DasunH/WolfTracker2014/Wolf Tracker/original_154245_jUmatnn3A8LtPPplB7qYOvOCr.jpg

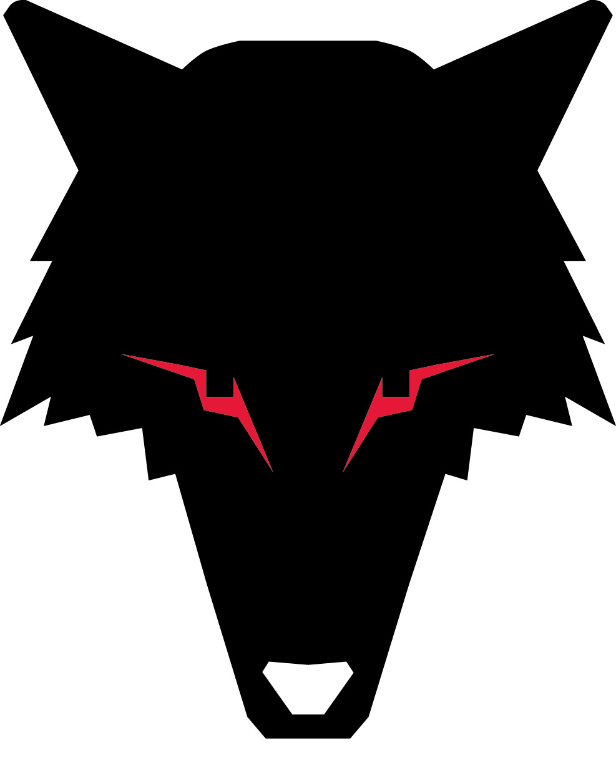
Wolf Tracker/original_154245_jUmatnn3A8LtPPplB7qYOvOCr.jpg
