DasunH/WolfTracker2014/Purchases/PurchasingTemplate.xlsx

PRODUCT | PART NUMBER | JUSTIFICATION | UNIT PRICE | QUANTITY | TOTAL PRICE | PURCHASING LINK
GoPro Hero3 White Edition |  | Capture Video | $199.99 | 1 | $199.99 | http://gopro.com/cameras/hd-hero3-white-edition
