DasunH/WolfTracker2014/Purchases/Wolf Tracker Parts List.xlsx

Part Name | Part Number | Unit Price | Quantity | Total Price | Link
32 Pitch Hub Gear (1" Bore) | 615222 | 12.99 | 1 | 12.99 | http://www.servocity.com/html/32_pitch_hub_gears__1__bore_.html#.U-pzZ4BdVy8
32 Pitch Aluminum Hub Gear (1/2" Bore) | 615210 | 12.99 | 1 | 12.99 | http://www.servocity.com/html/32_pitch_aluminum_hub_gears__1.html#.U-p0z4BdVy8
Flanged Ball Berings | 535049 | 2.79 | 1 | 2.79 | http://www.servocity.com/html/flanged_ball_bearings.html#.U-p1P4BdVy8
Swivel Hub | 545364 | 6.99 | 2 | 13.98 | http://www.servocity.com/html/swivel_hub__545364_.html#.U-p1xoBdVy8
Attachment Blocks | 585400 | 9.99 | 1 | 9.99 | http://www.servocity.com/html/attachment_blocks.html#.U-p2j4BdVy8
90 Degree Dual Side Mount B | 585508 | 5.99 | 2 | 11.98 | http://www.servocity.com/html/90o_dual_side_mount_b__585508_.html#.U-lxS4BdVy8
90 Degree Andle Bracket A | 858532 | 4.99 | 2 | 9.98 | http://www.servocity.com/html/90o_angle_bracket_a__585532_.html#.U-l0d4BdVy8
534-621 Bracket | 534-621 | 0.43 | 20 | 8.60 | http://www.servocity.com/html/534-621_bracket.html
1/2" Bore Tube Clamp Hub | 545350 | 5.99 | 2 | 11.98 | http://www.servocity.com/html/1_2__bore_tube_clamp_hub__5453.html#.U-p3ooBdVy8
90 Degree Hub Mount A | 545412 | 4.49 | 2 | 8.98 | http://www.servocity.com/html/90o_hub_mount_a__545412_.html#.U-p37oBdVy8
 |  |  | Total: | 104.26
