DasunH/WolfTracker2014/Purchases/Wolf-Turtle8-18.xlsx

Part Name | Part Number | Unit Price | Quantity | Total Price | Link
3/8" Aluminum Hex Standoff (1.5") | 91780A895 | $1.66 | 5 | $8.30 | http://www.mcmaster.com/#91780a895/=taixaf
3/8" Aluminum Hex Standoff (2.5") | 91780A901 | $1.94 | 5 | $9.70 | http://www.mcmaster.com/#91780a901/=taixp4
#25 Chain | 6261K171 | $30.84 | 1 | $30.84 | http://www.mcmaster.com/#6261k171/=taixpi
20 RPM Motor | 638174 | $24.99 | 1 | $24.99 | http://www.servocity.com/html/20_rpm_gear_motor.html
 |  |  | Total Cost: | $73.83
 | s
