DasunH/WolfTracker2014/Purchases/WolfPurchases7-22.xlsx

Product | Part Number | JUSTIFICATION | UNIT PRICE | QUANTITY | TOTAL PRICE | PURCHASING LINK
K478 Snow/Mud Tires | 160685 |  | $37.59 | 4 | $150.36 | http://www.jackssmallengines.com/Parts-Lookup/160685/61323/PL
Lead Acid Batteies | SLA-9A65 |  | $159.95 | 2 | $319.90 | http://www.batterymart.com/p-9a65-12-volt-group-65-agm-battery.html
D-Profile Shafts | 8632T7 (http://www.mcmaster.com/) |  | $9.93 | 4 | $39.72 | http://www.mcmaster.com/#8632t7/=syqar8
Flanged Ball Bearings | 535049 |  | $2.79 | 8 | $22.32 | http://www.servocity.com/html/flanged_ball_bearings.html#.U8_4avldWkB
Set Screw Hubs | 545560 |  | $4.99 | 12 | $59.88 | http://www.servocity.com/html/0_770__set_screw_hubs.html#.U8_6svldWkB
Hub Mount Sprokets | 615102 |  | $3.99 | 8 | $31.92 | http://www.servocity.com/html/aluminum_hub_mount_sprockets__.html#.U8_8V_ldWkB
Metal Chain | C250 |  | $8.99 | 10 | $89.90 | http://www.servocity.com/html/metal_chain.html#.U9AABPldWkB
Set Screw Collars | 6432K16 |  | $1.74 | 8 | $13.92 | http://www.servocity.com/html/steel_set_screw_collars.html#.U9ABd_ldWkA
Aluminum 90 Degree | 8982K61 |  | $15.53 | 1 | 15.53 | http://www.mcmaster.com/#8982k61/=t1uya7
Battery Terminal Connector | 7106K11 |  | 5.29 | 4 | $21.16 | http://www.mcmaster.com/#7106k11/=syb20a
Black 10 Gauge Wire |  |  | 2.5 | 7 | $17.50 | http://www.servocity.com/html/battery_wire.html#.U9ggefldWkA
Red 10 Gauge Wire |  |  | 2.5 | 2 | $5.00 | http://www.servocity.com/html/battery_wire.html#.U9ggefldWkA
 |  |  |  |  | $764.61
