DasunH/WolfTracker2014/Purchases/WolfPurchases8-11.xlsx

PRODUCT | PART NUMBER | JUSTIFICATION | UNIT PRICE | QUANTITY | TOTAL PRICE | PURCHASING LINK
Stainless Steel Friction Hinge | 1460A1 |  | $21.00 | 2 | $42.00 | http://www.mcmaster.com/#1460a1/=t8nnhd
90° Hub Mount Bracket A | 585494 |  | $5.99 | 8 | $47.92 | http://www.servocity.com/html/90o_hub_mount_bracket_a__58549.html#.U-lrO_ldWkA
90° Dual Side Mount | 585470 |  | $5.99 | 1 | $5.99 | http://www.servocity.com/html/90o_dual_side_mount__585470_.html#.U-lrJ_ldWkB
4-40 1" Standoffs | 91780A755 |  | $0.37 | 35 | $12.95 | http://www.mcmaster.com/#91780a755/=t9238x
 |  |  |  | Total | $108.86
