DasunH/WolfTracker2014/Purchases/WolfPurchases8-5.xlsx

PRODUCT | PART NUMBER | JUSTIFICATION | UNIT PRICE | QUANTITY | TOTAL PRICE | PURCHASING LINK
Wheel & Tire Assembly | V58-6510 |  | $29.99 | 4 | $119.96 | http://www.monsterscooterparts.com/13-5-6-minimoto-jeep-dune-buggy-front-wheel-assembly.html
Pelican 1095 Case | 1090-020-110 |  | $66.99 | 1 | $66.99 | http://www.amazon.com/Pelican-Products-1095-HardBack-1090-020-110/dp/B0069IYAA8
Battery Terminal Connector | 7106K11 |  | $5.29 | 4 | $21.16 | http://www.mcmaster.com/#7106k11/=syb20a
Black 10 Gauge Wire | W10 Black |  | $2.50 | 7 | $17.50 | http://www.servocity.com/html/battery_wire.html#.U9ggefldWkA
Red 10 Gauge Wire | W10 Red |  | $2.50 | 2 | $5.00 | http://www.servocity.com/html/battery_wire.html#.U9ggefldWkA
 |  |  |  | Total: | $230.61
