DasunH/WolfTracker2014/Wolf/Wolf Tracker 4.0/Final V4/Prototype ATR Wheel Assembly V3.SLDASM

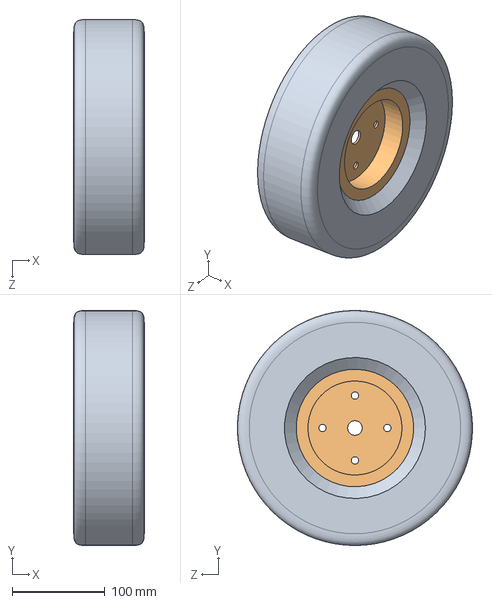
[picture p25: CAD file, 2014-09-02]
Wolf/Wolf Tracker 4.0/Final V4/Prototype ATR Wheel Assembly V3.SLDASM
76.2 x 254.0 x 253.9 mm
Prototype ATR Tire V3
Prototype ATR Wheel Rim V3
