DasunH/WolfTracker2014/Wolf Tracker/Final V4/Final Rover Assembly V4.SLDASM

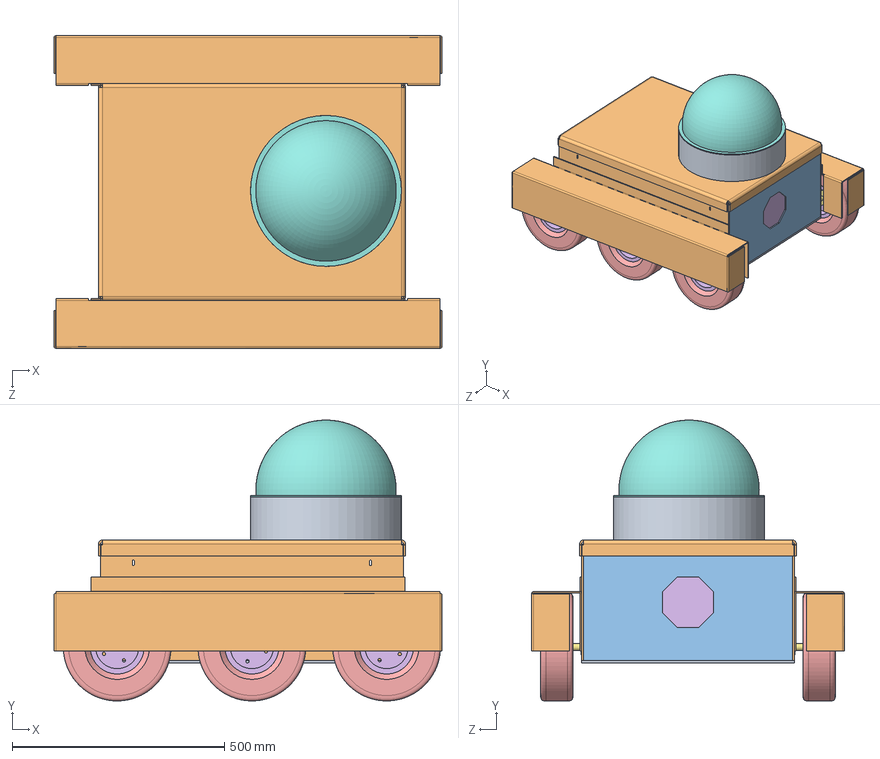
[picture p26: CAD file, 2014-09-02]
Wolf Tracker/Final V4/Final Rover Assembly V4.SLDASM
914.4 x 662.0 x 737.2 mm
Final Base-Bottom V4
Final Base-LR V4 x 2
Final Base-FB V4 x 2
Prototype IG52 Motor x 6
Prototype ATR Tire V3 x 6
Prototype ATR Wheel Rim V3 x 6
Prototype ATR Wheel Hub V3 x 6
Final Aluminum Bar V4 x 2
Final 0.625'' Bore Sealed Bearing V4 x 6
Final Case Top V4
Prototype No 5 Corner Piece V3 x 4
Atom Board
Final 24-12V Converter
Final 120MM Fan x 2
Final Inside Corner Bracket x 8
EZtop Dome
PVC Pipe
Final Tire Cover V4 x 2
