DasunH/WolfTracker2014/Wolf Tracker/Final V4/Final ATR Drivetrain Assembly V4.SLDASM

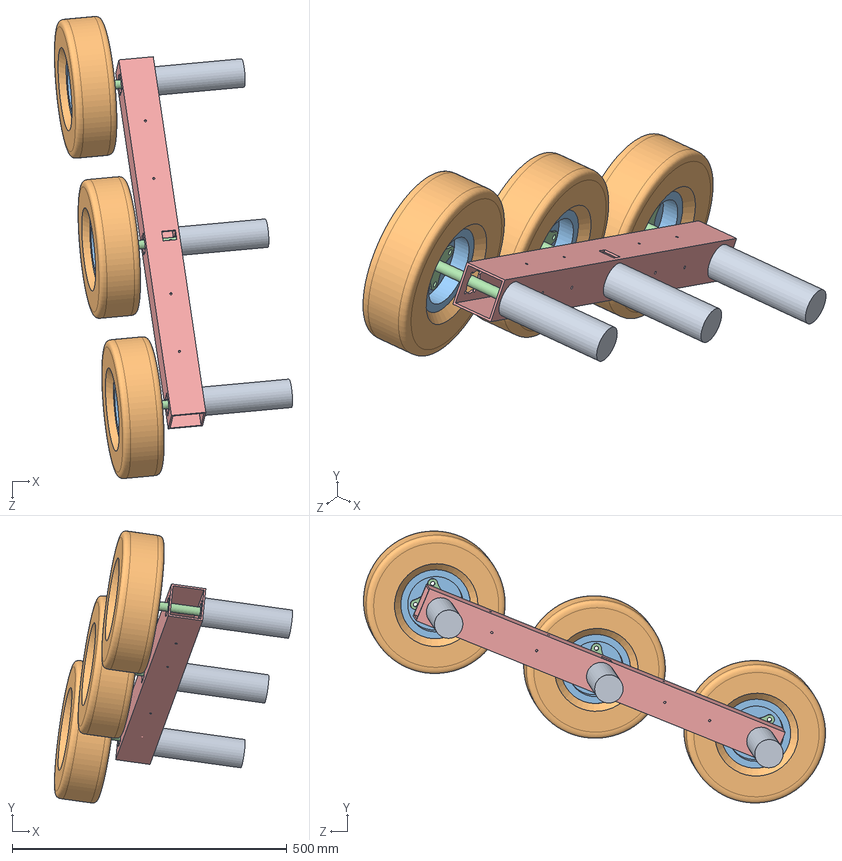
[picture p27: CAD file, 2014-09-02]
Wolf Tracker/Final V4/Final ATR Drivetrain Assembly V4.SLDASM
433.6 x 495.0 x 841.2 mm
Prototype IG52 Motor x 3
Prototype ATR Tire V3 x 3
Prototype ATR Wheel Rim V3 x 3
Prototype ATR Wheel Hub V3 x 3
Final Aluminum Bar V4
