DasunH/WolfTracker2014/Wolf/WolfTurret2.0/Turrent3.0.SLDASM

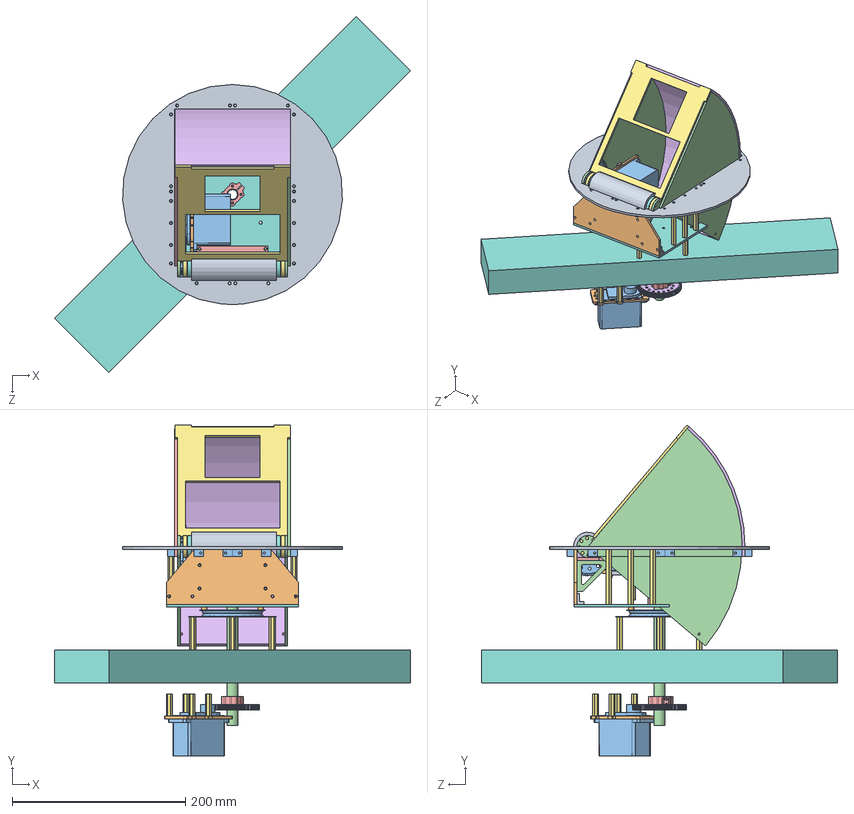
[picture p28: CAD file, 2014-09-02]
Wolf/WolfTurret2.0/Turrent3.0.SLDASM
410.9 x 382.0 x 410.9 mm
TurretBasePlate
BottomMountingPlate
SquareMountingBracket x 16
TurretSideProtectionRight
TurretSideProtectionLeft
TurretShieldBacking
HexStandoffInch x 10
TurningPlate
LongSquareBracket x 3
Spacer x 4
Turntable
TriangleMountingBracket x 2
BottomMountingPlateTop3
CircleMountingBracket x 2
Swivel HubScrew x 2
Swivel HubNut x 2
NylonNut x 2
HexScrew(.3125) x 2
HalfBore84TCUT
TurretSidePannel x 2
AllignmentDowel x 2
TurretBackPlate
TurretFrontPannel2.0
2by4
PVCShield
ServoMount2 x 2
QuarterServo x 2
.5InchTube
.5InchTubeClamp x 2
.5InchBore76ToothGear
OneInchStandoff x 5
