DasunH/WolfTracker2014/WolfTurret2.0/TiltServoMount2.SLDASM

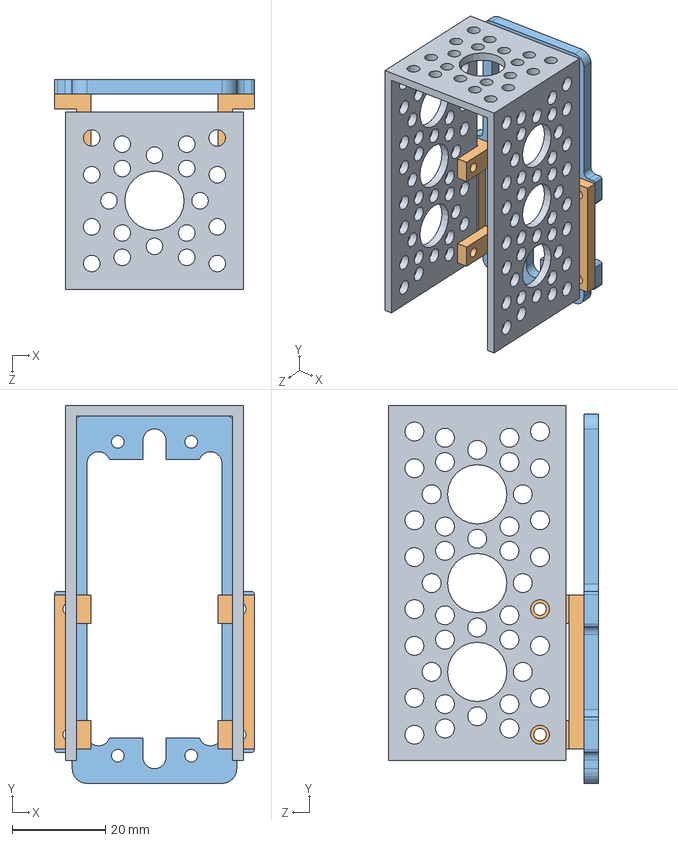
[picture p29: CAD file, 2014-09-02]
WolfTurret2.0/TiltServoMount2.SLDASM
42.9 x 81.1 x 45.1 mm
ChannelABracket
LongSquareBracket x 2
ServoMount
