DasunH/WolfTracker2014/Wolf Tracker 2.0/NewTire.SLDPRT

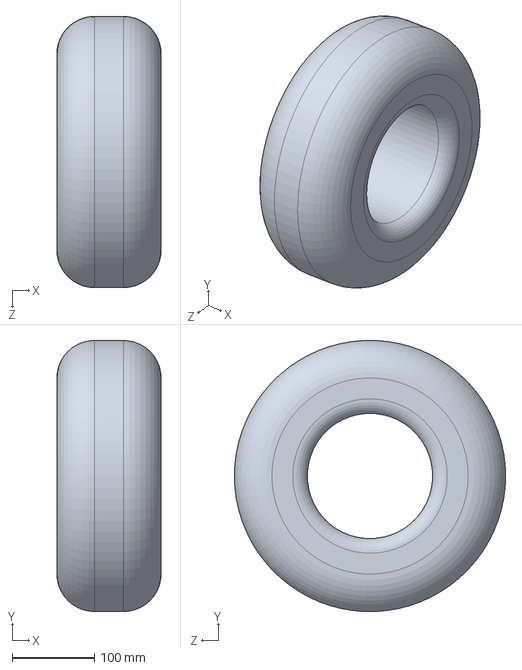
[picture p30: CAD file, 2014-09-02]
Wolf Tracker 2.0/NewTire.SLDPRT
127.0 x 329.9 x 330.2 mm
