DasunH/WolfTracker2014/Wolf Tracker 3.0/BasePlate.SLDPRT

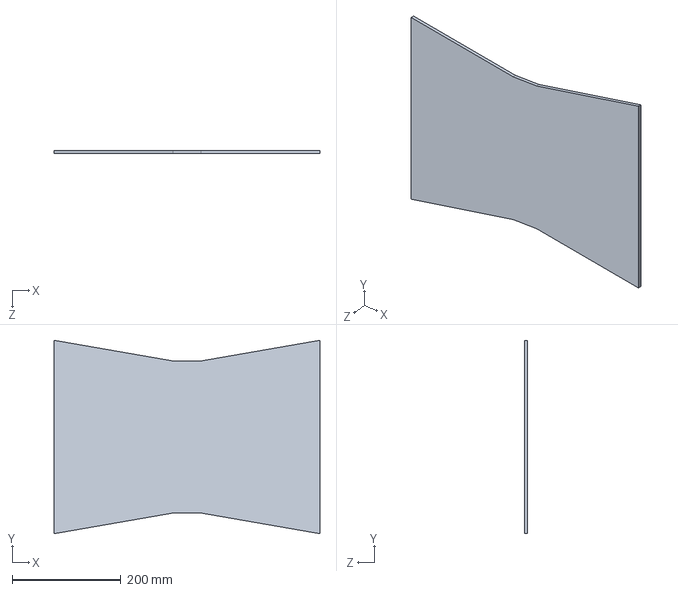
[picture p31: CAD file, 2014-09-02]
Wolf Tracker 3.0/BasePlate.SLDPRT
489.0 x 355.6 x 6.35 mm
