DasunH/WolfTracker2014/Wolf Tracker 4.0/Final V4/Final 0.625'' Bore Sealed Bearing V4.SLDPRT

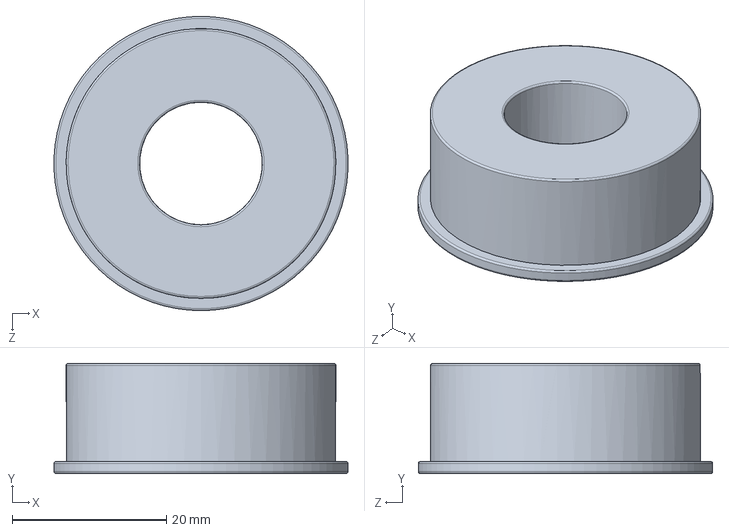
[picture p32: CAD file, 2014-09-02]
Wolf Tracker 4.0/Final V4/Final 0.625'' Bore Sealed Bearing V4.SLDPRT
38.1 x 14.3 x 38.1 mm
