DasunH/WolfTracker2014/Wolf Tracker 4.0/Final V4/Mill/Final Aluminum Bar V4.SLDPRT

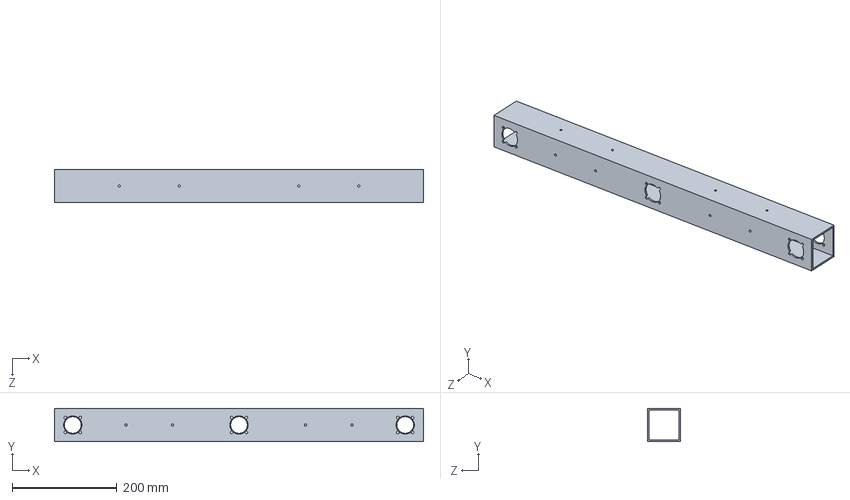
[picture p33: CAD file, 2014-09-02]
Wolf Tracker 4.0/Final V4/Mill/Final Aluminum Bar V4.SLDPRT
704.9 x 63.5 x 63.5 mm
