DasunH/WolfTracker2014/Wolf Tracker/Final V4/Final Base-FB V4.SLDPRT

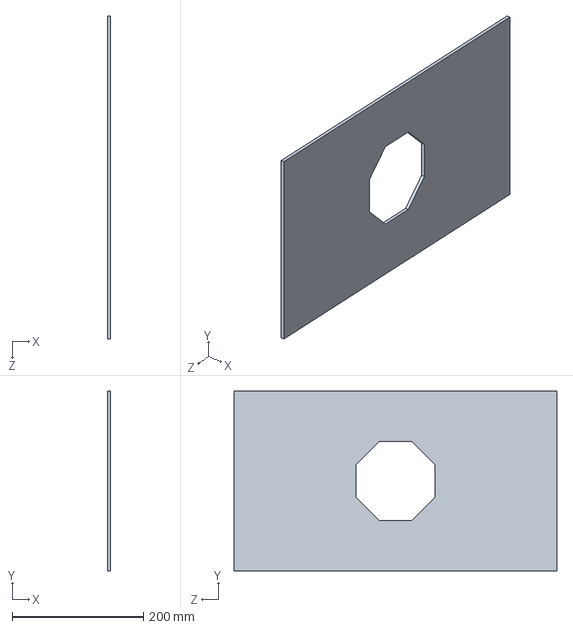
[picture p34: CAD file, 2014-09-02]
Wolf Tracker/Final V4/Final Base-FB V4.SLDPRT
4.76 x 274.6 x 492.1 mm
