DasunH/WolfTracker2014/Wolf/Wolf Tracker 4.0/Final V4/Final Case Top V4.SLDPRT

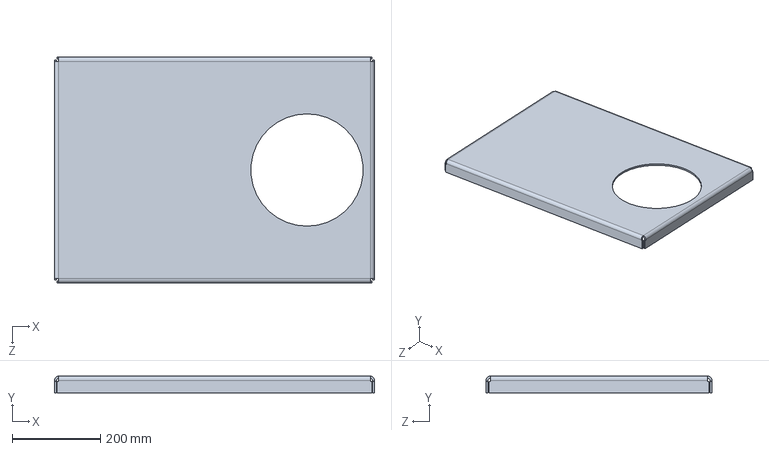
[picture p35: CAD file, 2014-09-02]
Wolf/Wolf Tracker 4.0/Final V4/Final Case Top V4.SLDPRT
723.9 x 38.1 x 511.0 mm
