DasunH/WolfTracker2014/Wolf/Wolf Tracker 4.0/New Back Plate.SLDPRT

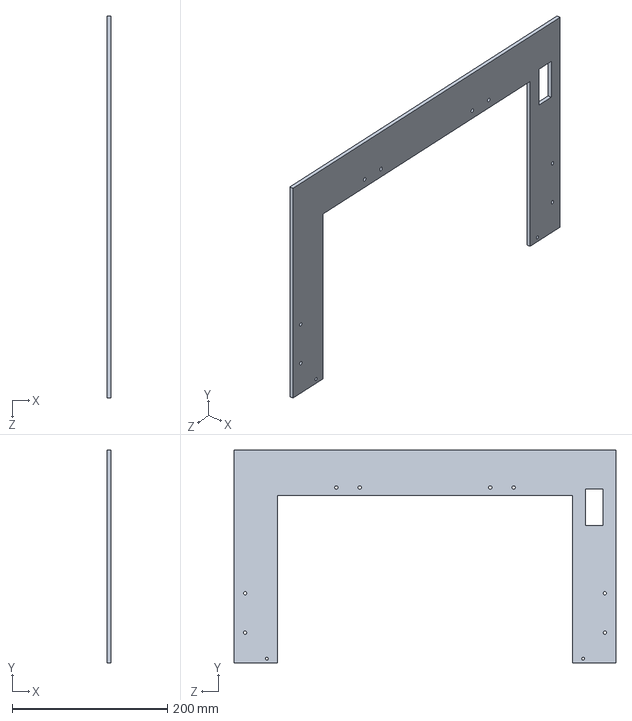
[picture p36: CAD file, 2014-09-02]
Wolf/Wolf Tracker 4.0/New Back Plate.SLDPRT
4.76 x 274.6 x 492.1 mm
