DasunH/WolfTracker2014/Wolf/WolfTurret2.0/TurretFrontPannel2.0.SLDPRT

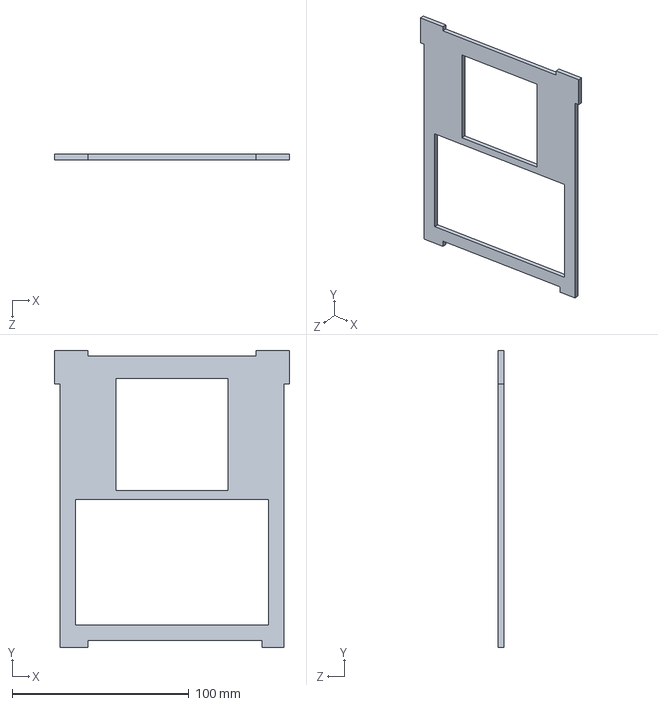
[picture p37: CAD file, 2014-09-02]
Wolf/WolfTurret2.0/TurretFrontPannel2.0.SLDPRT
133.4 x 168.3 x 3.17 mm
