DasunH/WolfTracker2014/WolfTurret2.0/BottomMountingPlateTop3.SLDPRT

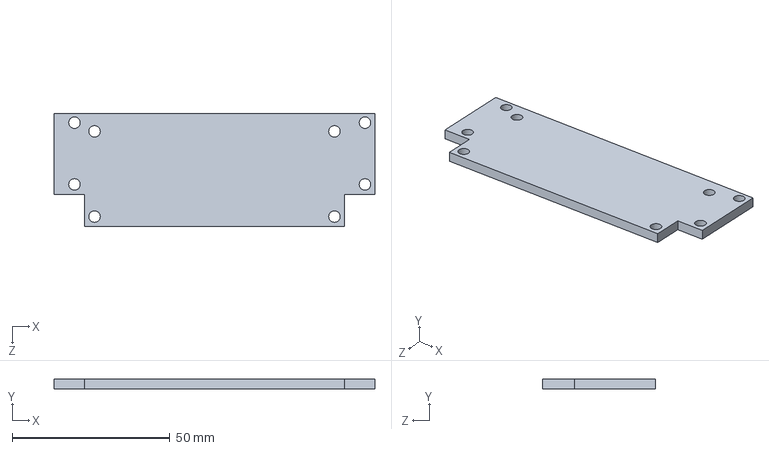
[picture p38: CAD file, 2014-09-02]
WolfTurret2.0/BottomMountingPlateTop3.SLDPRT
101.6 x 3.17 x 35.8 mm
