DasunH/WolfTracker2014/Wolf Tracker 2.0/MotorBracket.SLDPRT

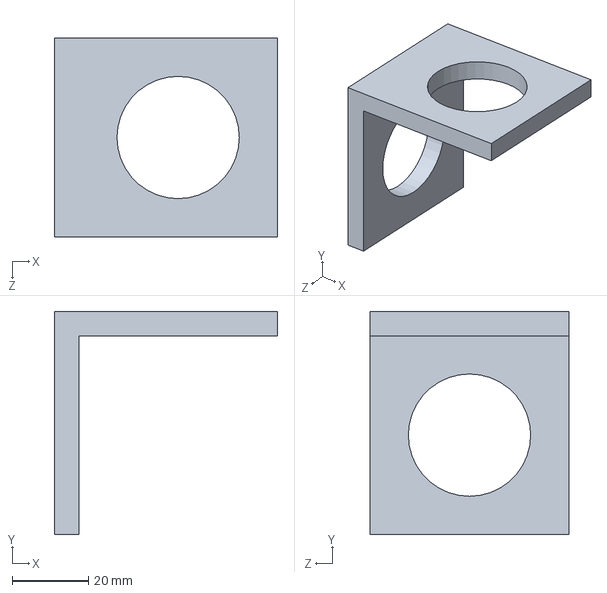
[picture p39: CAD file, 2014-09-02]
Wolf Tracker 2.0/MotorBracket.SLDPRT
58.4 x 58.4 x 52.0 mm
