DasunH/WolfTracker2014/Wolf Tracker 4.0/BatteryRail1.SLDPRT

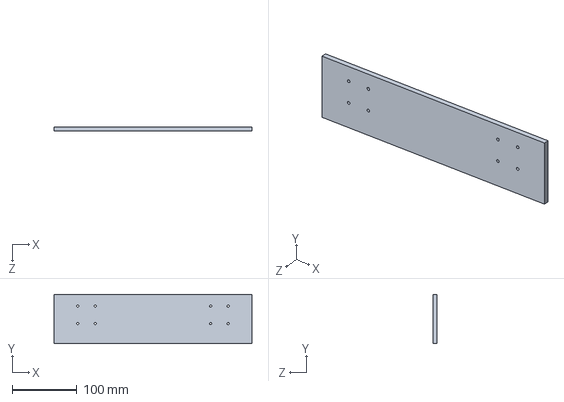
[picture p40: CAD file, 2014-09-02]
Wolf Tracker 4.0/BatteryRail1.SLDPRT
304.8 x 76.2 x 6.35 mm
