DasunH/WolfTracker2014/Wolf Tracker 4.0/Final V4/Final Aluminum Bar V4II.SLDPRT

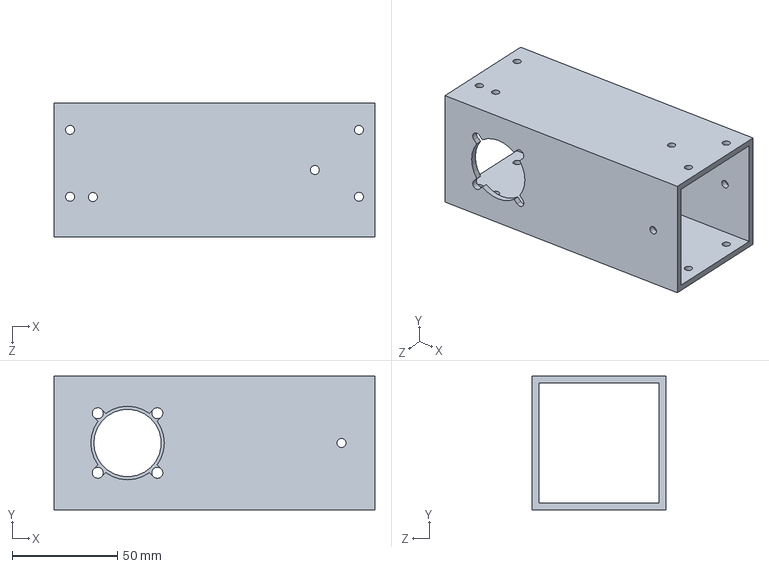
[picture p41: CAD file, 2014-09-02]
Wolf Tracker 4.0/Final V4/Final Aluminum Bar V4II.SLDPRT
152.4 x 63.5 x 63.5 mm
