DasunH/WolfTracker2014/Wolf/WolfTurret2.0/TurretSidePannel.SLDPRT

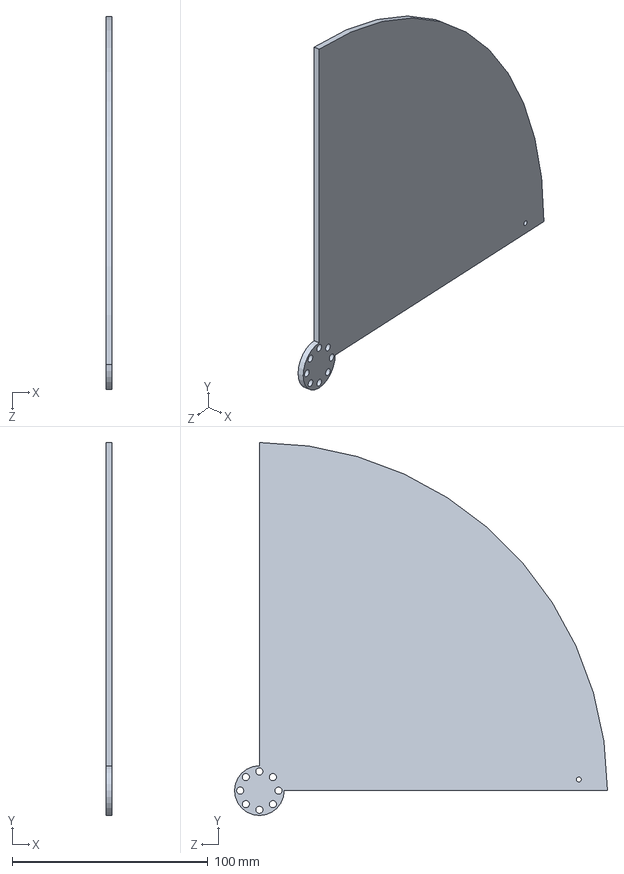
[picture p42: CAD file, 2014-09-02]
Wolf/WolfTurret2.0/TurretSidePannel.SLDPRT
3.17 x 190.5 x 190.5 mm
