DasunH/WolfTracker2014/WolfTurret2.0/HexStandoffInch.SLDPRT

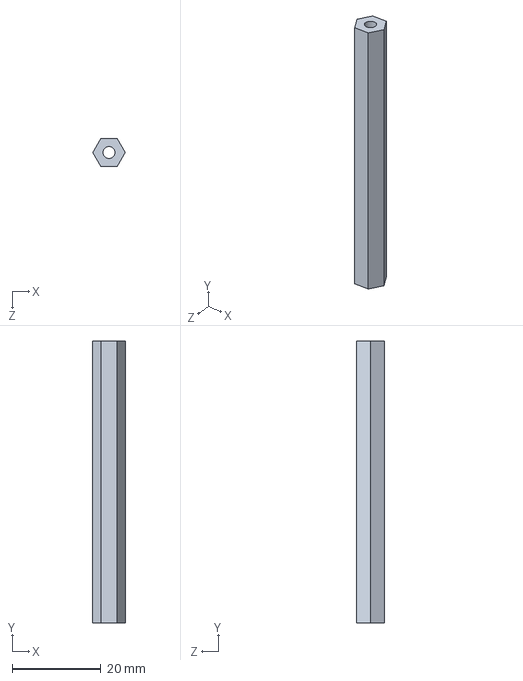
[picture p43: CAD file, 2014-09-02]
WolfTurret2.0/HexStandoffInch.SLDPRT
7.33 x 63.5 x 6.37 mm
