DasunH/WolfTracker2014/Wolf Tracker 2.0/Motor.SLDPRT

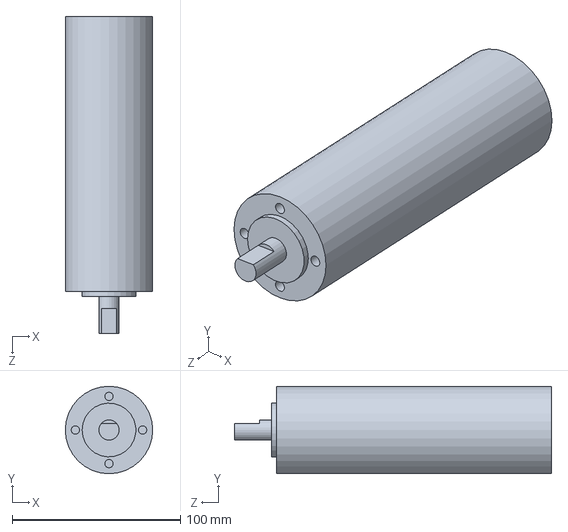
[picture p44: CAD file, 2014-09-02]
Wolf Tracker 2.0/Motor.SLDPRT
52.0 x 52.0 x 188.5 mm
