DasunH/WolfTracker2014/Wolf Tracker 3.0/SuspensionPlates.SLDPRT

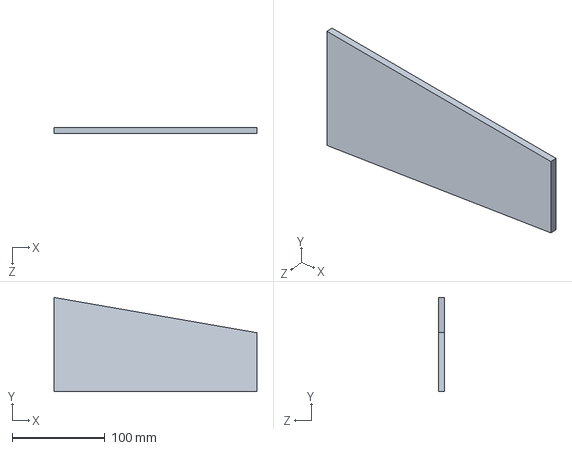
[picture p45: CAD file, 2014-09-02]
Wolf Tracker 3.0/SuspensionPlates.SLDPRT
219.1 x 101.6 x 6.35 mm
