DasunH/WolfTracker2014/Wolf Tracker 4.0/Final V4/Final Tire Cover V4.SLDPRT

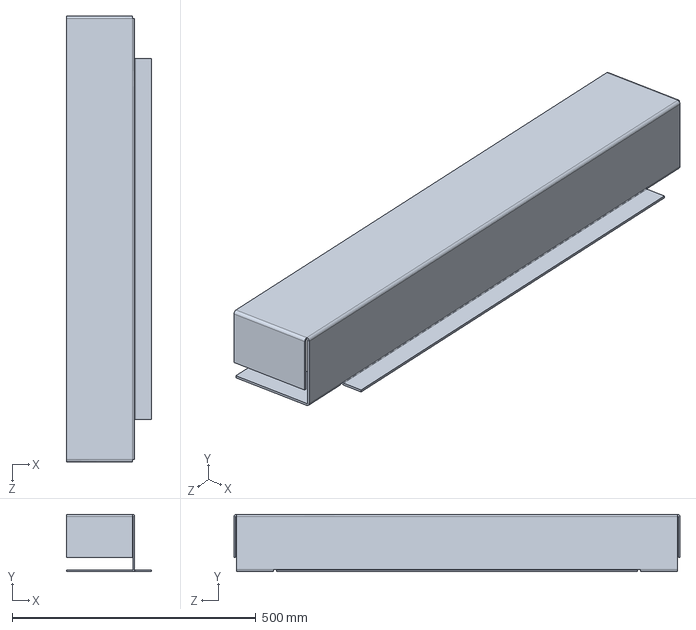
[picture p46: CAD file, 2014-09-02]
Wolf Tracker 4.0/Final V4/Final Tire Cover V4.SLDPRT
174.6 x 117.8 x 914.4 mm
