DasunH/WolfTracker2014/Wolf Tracker 4.0/New Back Plate.SLDPRT

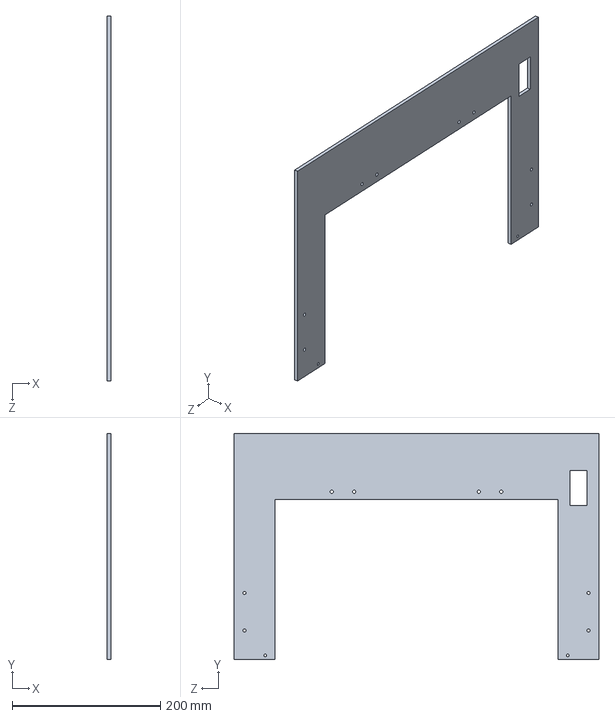
[picture p47: CAD file, 2014-09-02]
Wolf Tracker 4.0/New Back Plate.SLDPRT
4.76 x 304.8 x 492.1 mm
