DasunH/WolfTracker2014/Wolf Tracker/Final V4/Prototype ATR Wheel Rim V3.SLDPRT

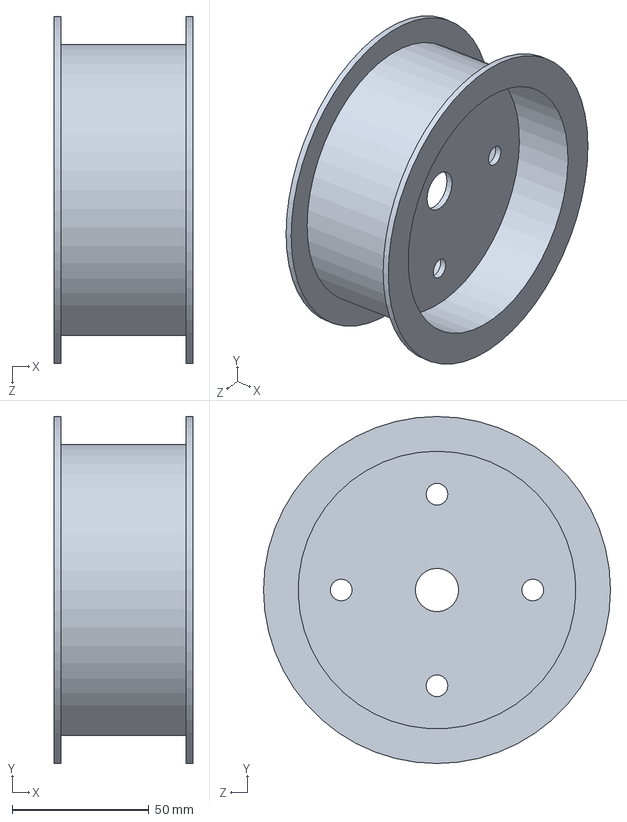
[picture p48: CAD file, 2014-09-02]
Wolf Tracker/Final V4/Prototype ATR Wheel Rim V3.SLDPRT
50.8 x 127.0 x 127.0 mm
