DasunH/WolfTracker2014/Wolf/Wolf Tracker 4.0/8-32--buttonhead.SLDPRT

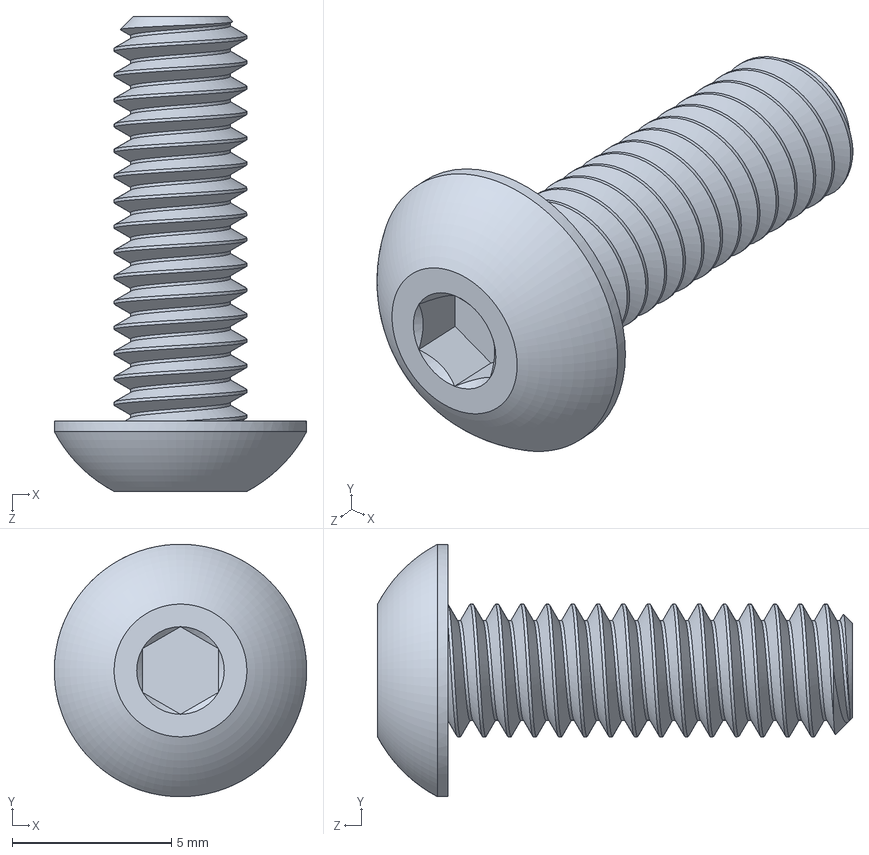
[picture p49: CAD file, 2014-09-02]
Wolf/Wolf Tracker 4.0/8-32--buttonhead.SLDPRT
7.92 x 7.92 x 14.9 mm
