DasunH/WolfTracker2014/Wolf/Wolf Tracker 4.0/Final V4/Final Gimbal Protector.SLDPRT

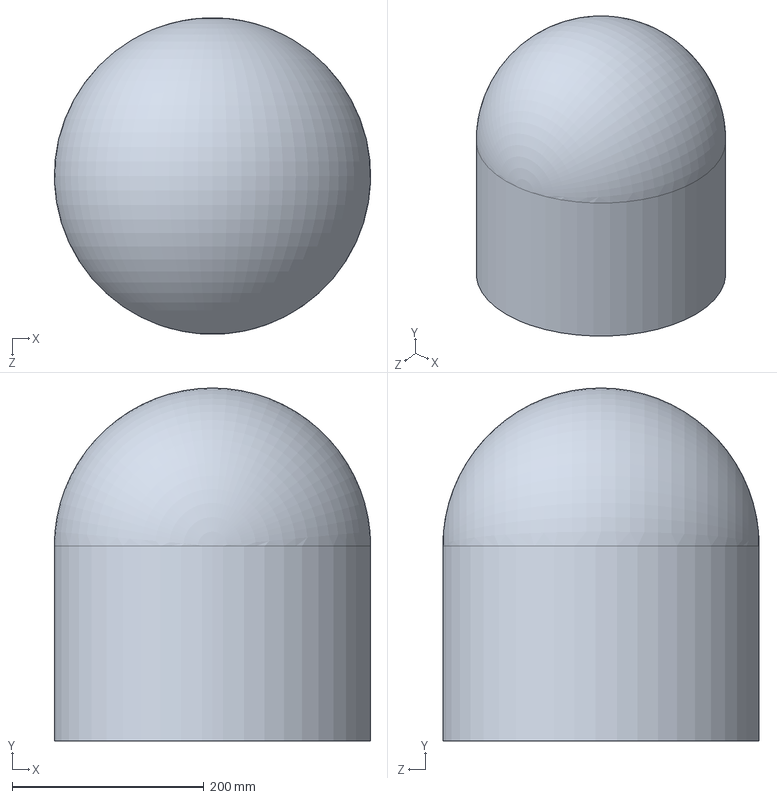
[picture p50: CAD file, 2014-09-02]
Wolf/Wolf Tracker 4.0/Final V4/Final Gimbal Protector.SLDPRT
330.0 x 368.3 x 330.2 mm
