DasunH/WolfTracker2014/WolfTurret2.0/.5InchTube.SLDPRT

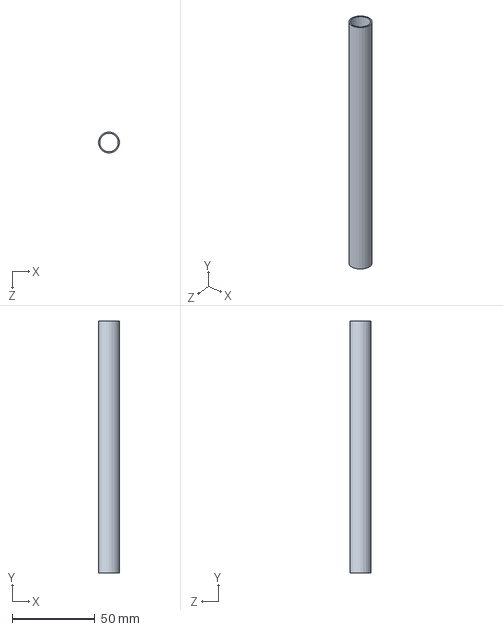
[picture p51: CAD file, 2014-09-02]
WolfTurret2.0/.5InchTube.SLDPRT
12.7 x 152.4 x 12.7 mm
