DasunH/WolfTracker2014/Wolf Tracker 3.0/Spine.SLDPRT

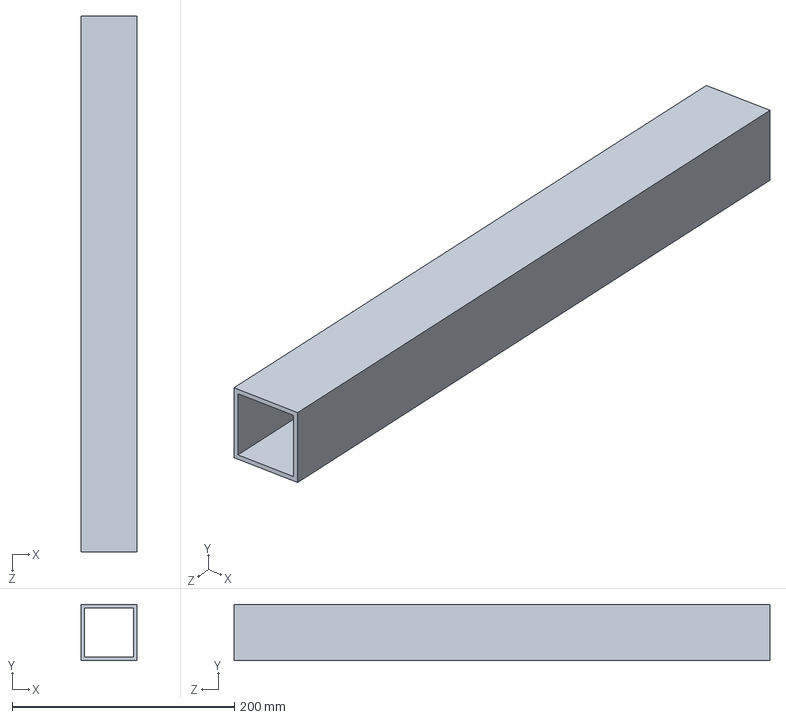
[picture p52: CAD file, 2014-09-02]
Wolf Tracker 3.0/Spine.SLDPRT
50.8 x 50.8 x 482.6 mm
