DasunH/WolfTracker2014/Wolf Tracker/Final V4/Final 120MM Fan.SLDPRT

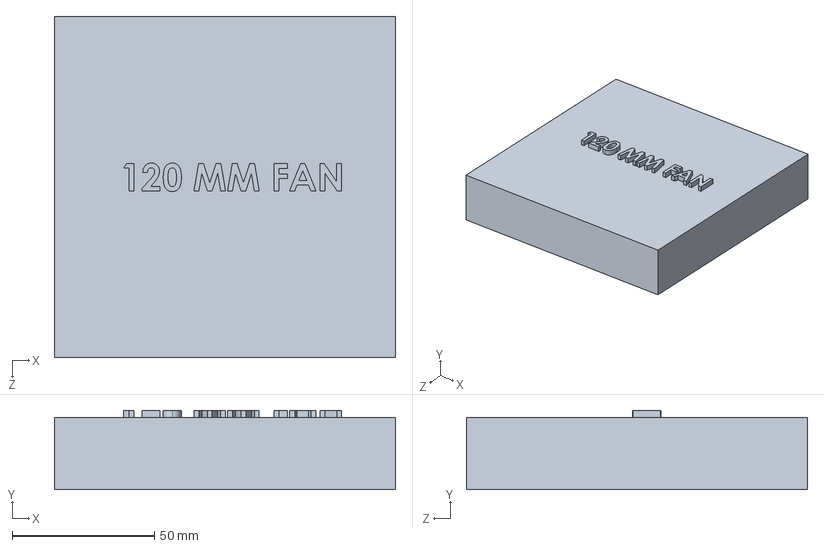
[picture p53: CAD file, 2014-09-02]
Wolf Tracker/Final V4/Final 120MM Fan.SLDPRT
120.0 x 27.9 x 120.0 mm
