DasunH/WolfTracker2014/Wolf/Wolf Tracker 4.0/Final V4/Prototype No 5 Corner Piece V3.SLDPRT

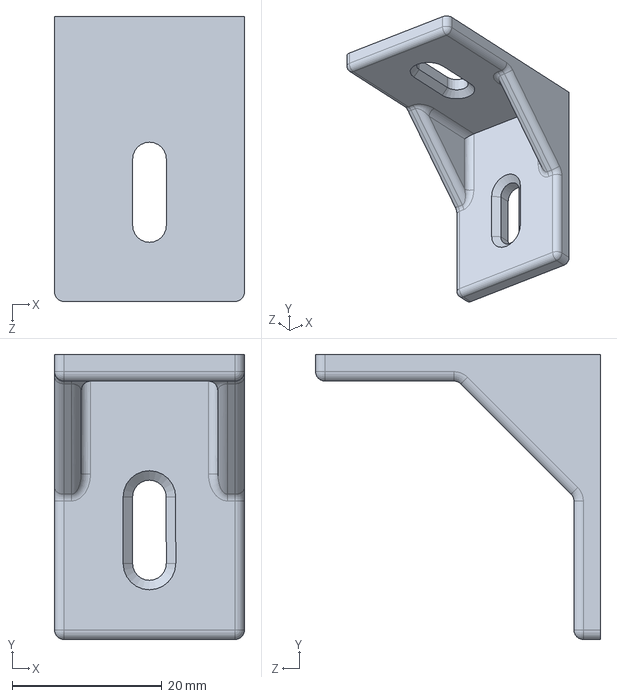
[picture p54: CAD file, 2014-09-02]
Wolf/Wolf Tracker 4.0/Final V4/Prototype No 5 Corner Piece V3.SLDPRT
25.4 x 38.1 x 38.1 mm
