DasunH/WolfTracker2014/Wolf/WolfTurret2.0/CameraMountingDimensions.SLDPRT

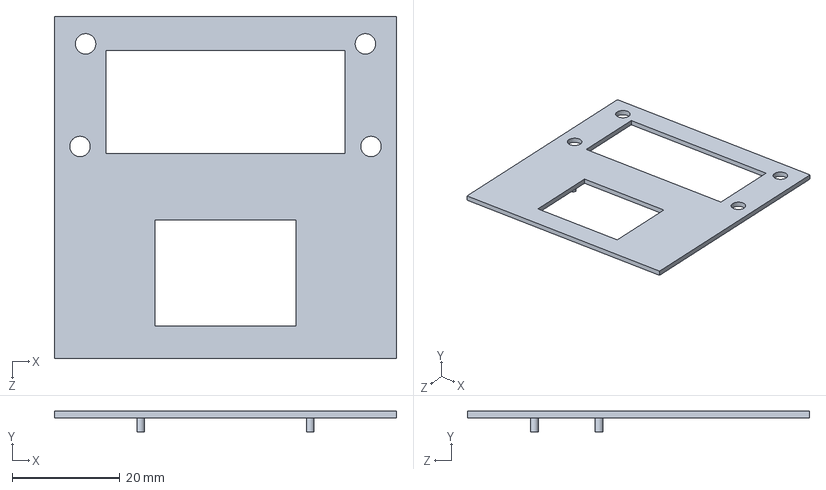
[picture p55: CAD file, 2014-09-02]
Wolf/WolfTurret2.0/CameraMountingDimensions.SLDPRT
63.5 x 3.81 x 63.5 mm
