DasunH/WolfTracker2014/WolfTurret2.0/NylonNut.SLDPRT

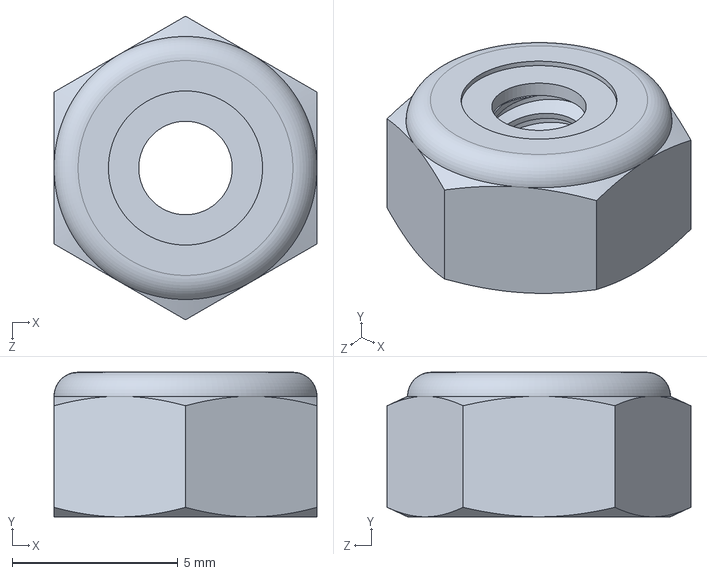
[picture p56: CAD file, 2014-09-02]
WolfTurret2.0/NylonNut.SLDPRT
7.94 x 4.37 x 9.17 mm
