DasunH/WolfTracker2014/Wolf Tracker 2.0/Battery.SLDPRT

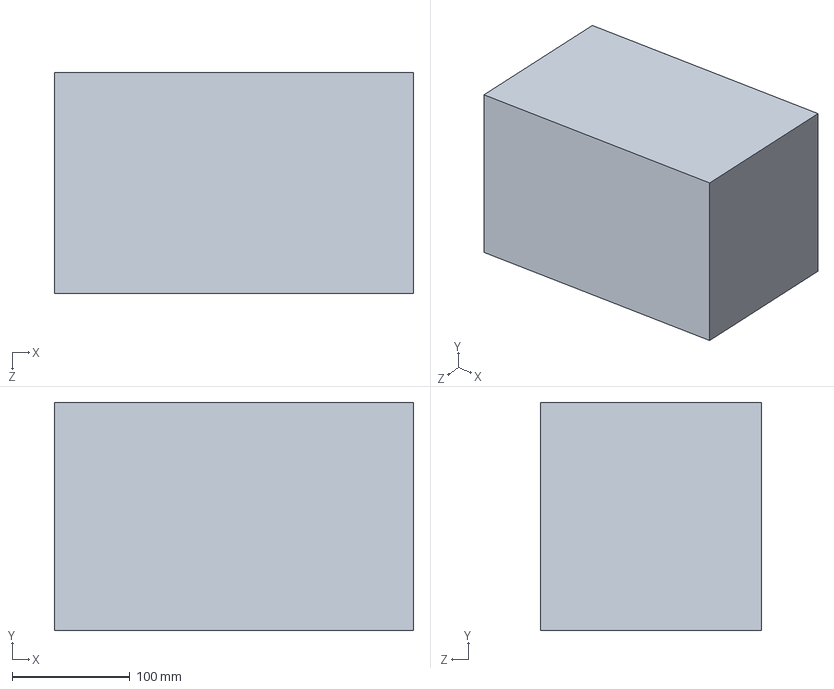
[picture p57: CAD file, 2014-09-02]
Wolf Tracker 2.0/Battery.SLDPRT
304.8 x 193.7 x 187.3 mm
