DasunH/WolfTracker2014/Wolf Tracker 4.0/Final V4/Final Tire Cover 4C.SLDPRT

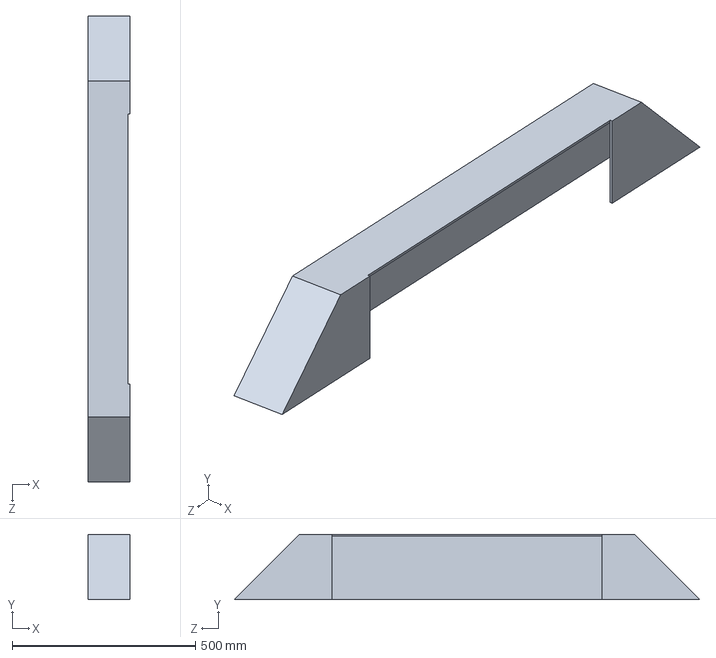
[picture p58: CAD file, 2014-09-02]
Wolf Tracker 4.0/Final V4/Final Tire Cover 4C.SLDPRT
114.3 x 177.8 x 1270.0 mm
