DasunH/WolfTracker2014/Wolf Tracker 4.0/Switch.SLDPRT

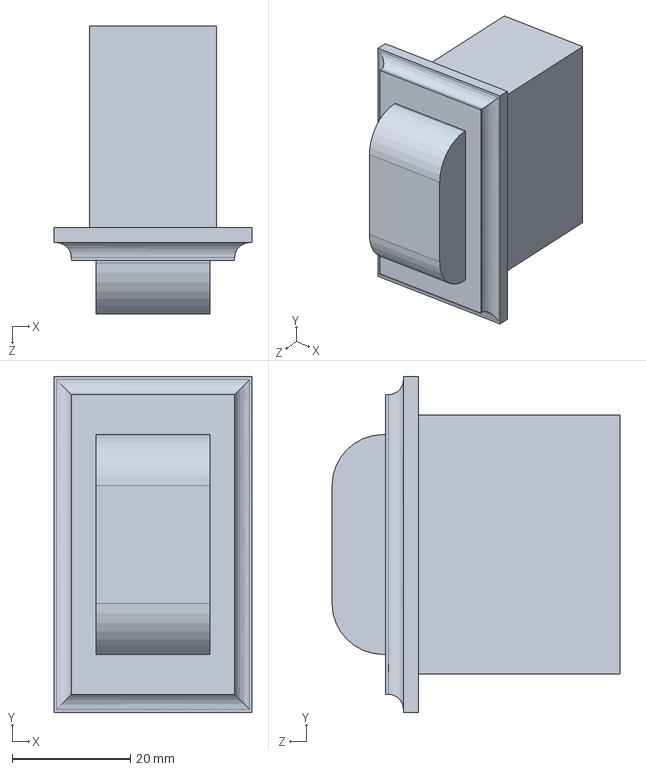
[picture p59: CAD file, 2014-09-02]
Wolf Tracker 4.0/Switch.SLDPRT
33.4 x 56.8 x 48.7 mm
