DasunH/WolfTracker2014/Wolf Tracker/Final V4/Final Tire Cover V4C.SLDPRT

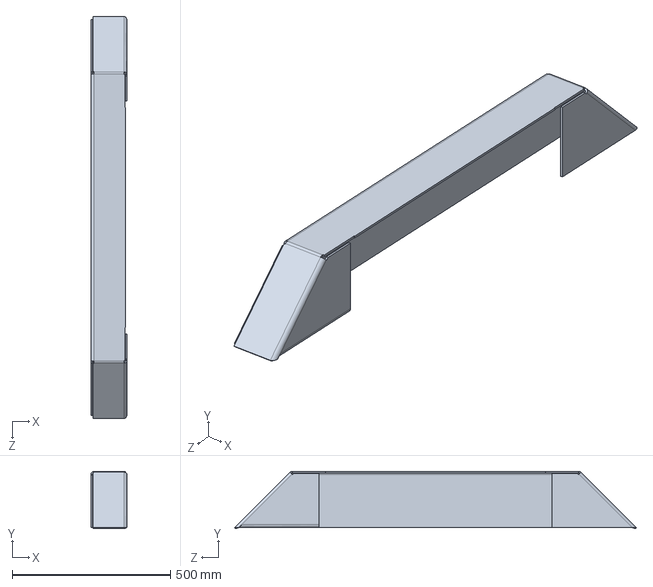
[picture p60: CAD file, 2014-09-02]
Wolf Tracker/Final V4/Final Tire Cover V4C.SLDPRT
114.3 x 181.2 x 1270.0 mm
