DasunH/WolfTracker2014/Wolf/Wolf Tracker 4.0/Final V4/Final Battery Base.SLDPRT

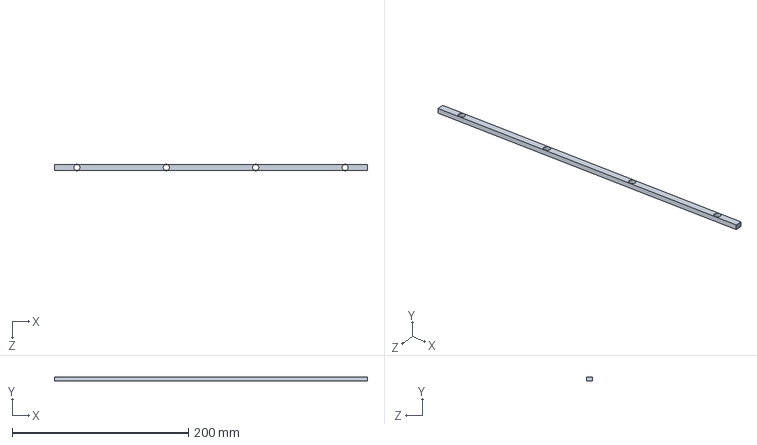
[picture p61: CAD file, 2014-09-02]
Wolf/Wolf Tracker 4.0/Final V4/Final Battery Base.SLDPRT
355.6 x 5.08 x 7.30 mm
