DasunH/WolfTracker2014/WolfTurret2.0/HalfBore48T.SLDPRT

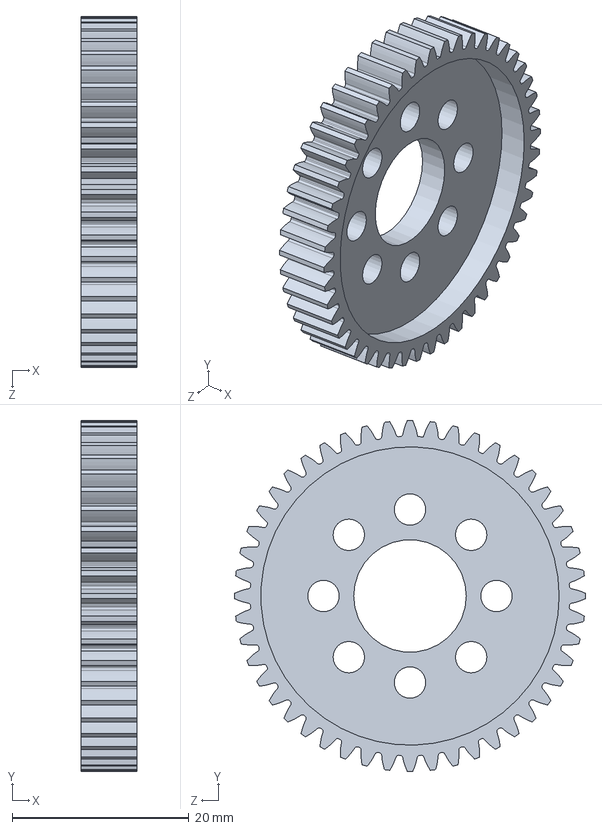
[picture p62: CAD file, 2014-09-02]
WolfTurret2.0/HalfBore48T.SLDPRT
6.35 x 39.7 x 39.7 mm
