DasunH/WolfTracker2014/Wolf Tracker 2.0/SidePanelLarge.SLDPRT

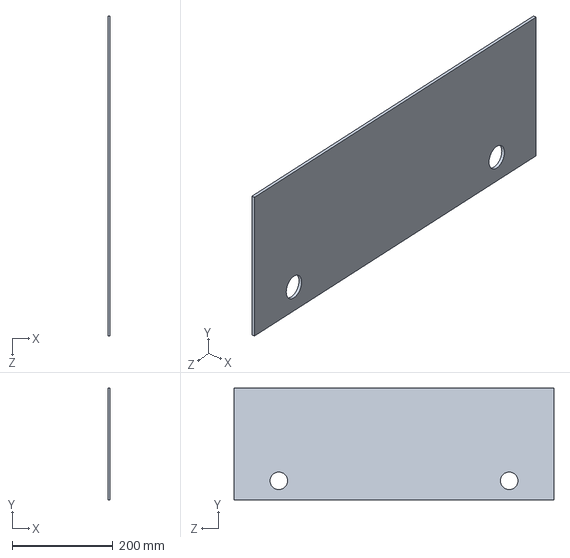
[picture p63: CAD file, 2014-09-02]
Wolf Tracker 2.0/SidePanelLarge.SLDPRT
4.76 x 222.2 x 635.0 mm
