DasunH/WolfTracker2014/Wolf Tracker 4.0/PelicanBracket.SLDPRT

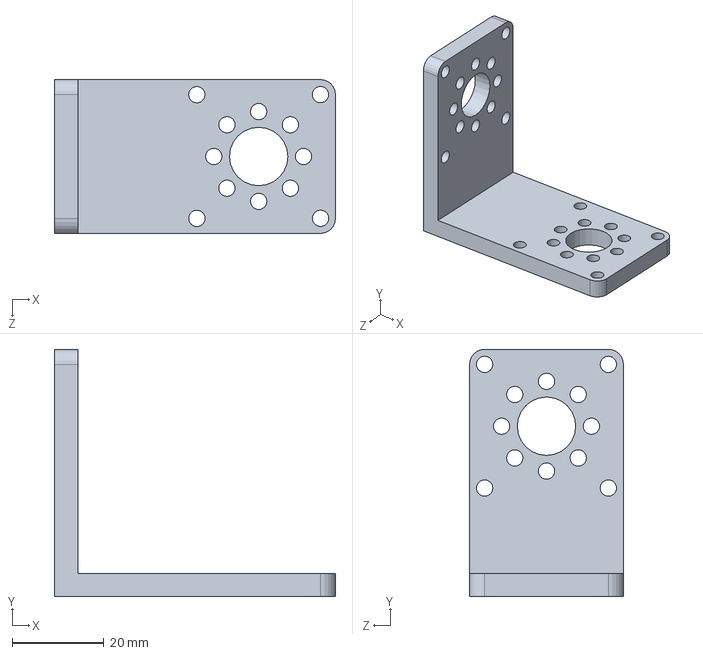
[picture p64: CAD file, 2014-09-02]
Wolf Tracker 4.0/PelicanBracket.SLDPRT
61.2 x 53.9 x 33.5 mm
