DasunH/WolfTracker2014/Wolf/Wolf Tracker 4.0/UnderrideGuard.SLDPRT

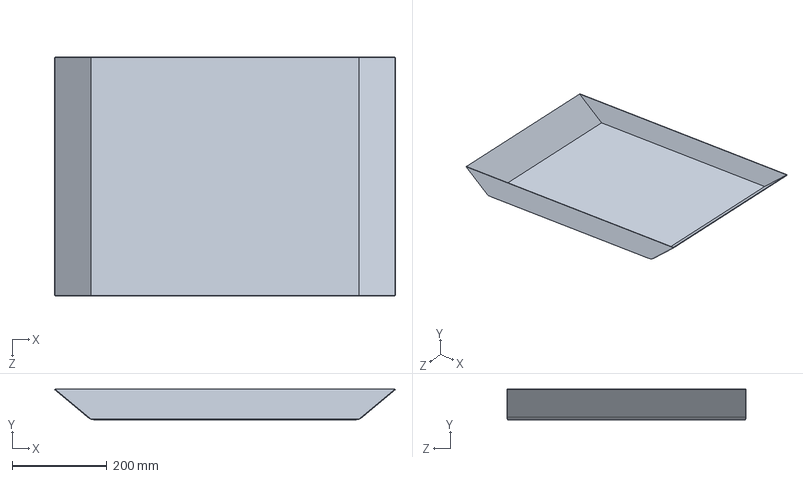
[picture p65: CAD file, 2014-09-02]
Wolf/Wolf Tracker 4.0/UnderrideGuard.SLDPRT
718.9 x 65.2 x 504.8 mm
