DasunH/WolfTracker2014/WolfTurret2.0/.5InchTubeClamp.SLDPRT

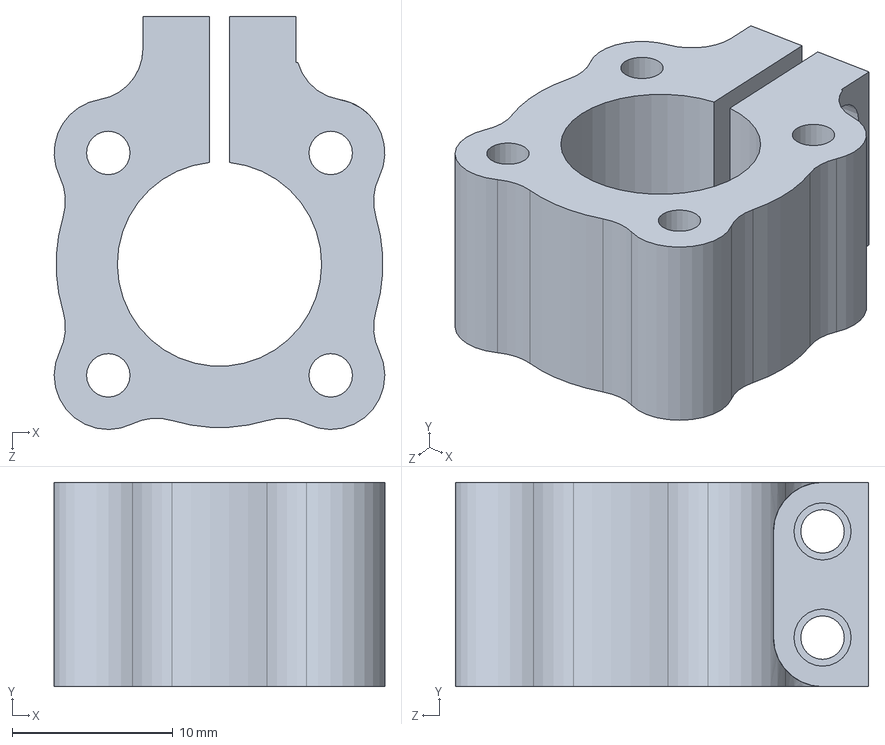
[picture p66: CAD file, 2014-09-02]
WolfTurret2.0/.5InchTubeClamp.SLDPRT
20.6 x 12.7 x 25.7 mm
