DasunH/WolfTracker2014/Wolf Tracker 2.0/Dome.SLDPRT

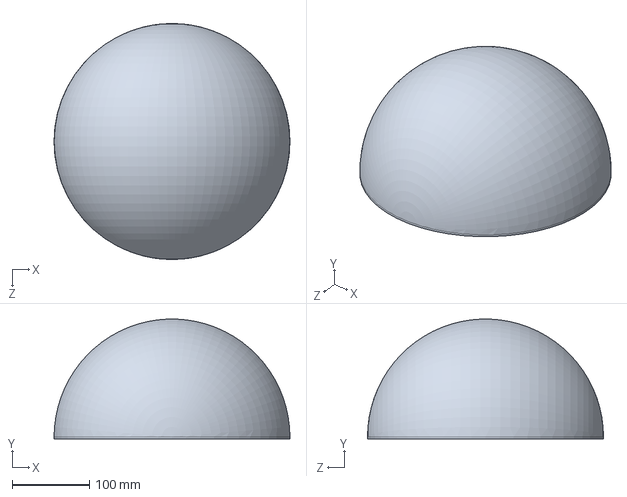
[picture p67: CAD file, 2014-09-02]
Wolf Tracker 2.0/Dome.SLDPRT
304.8 x 154.7 x 304.8 mm
