DasunH/WolfTracker2014/Wolf Tracker 4.0/Final V4/Prototype Polycarbonate Shelf V3B.SLDPRT

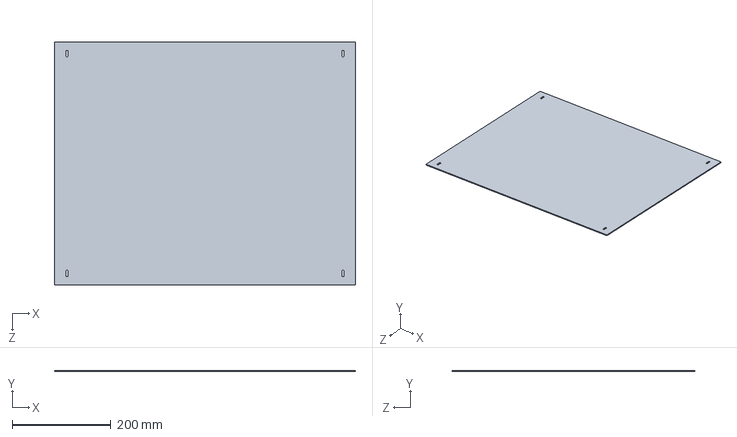
[picture p68: CAD file, 2014-09-02]
Wolf Tracker 4.0/Final V4/Prototype Polycarbonate Shelf V3B.SLDPRT
609.6 x 2.54 x 492.1 mm
