DasunH/WolfTracker2014/Wolf Tracker 4.0/FrictionHinge.SLDPRT

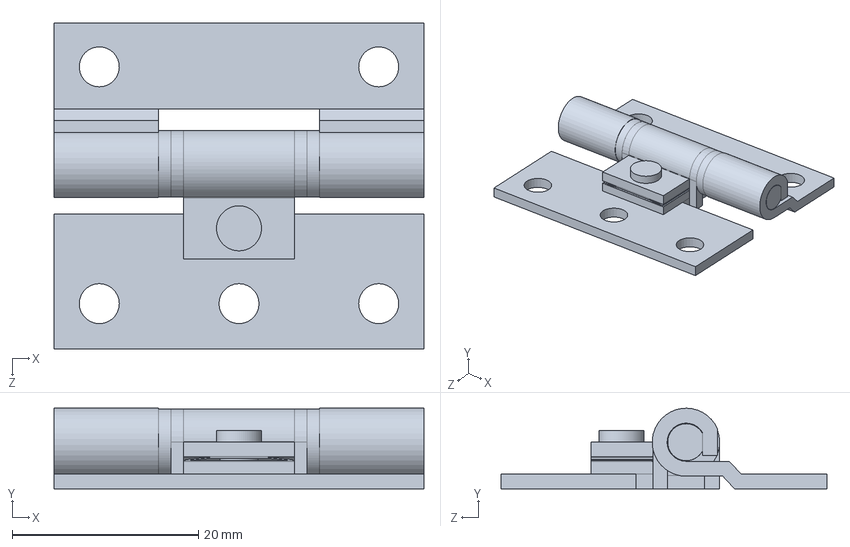
[picture p69: CAD file, 2014-09-02]
Wolf Tracker 4.0/FrictionHinge.SLDPRT
39.7 x 8.65 x 34.9 mm
