DasunH/WolfTracker2014/Wolf/Wolf Tracker 4.0/BackDoor.SLDPRT

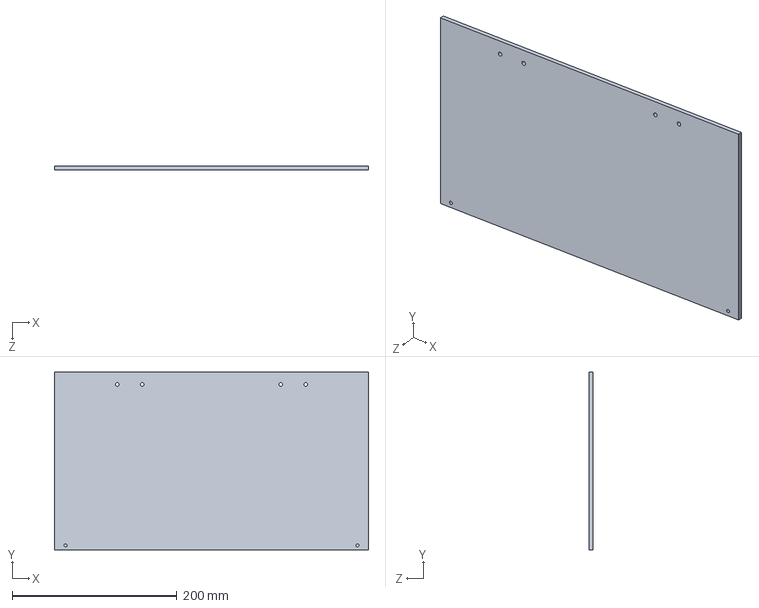
[picture p70: CAD file, 2014-09-02]
Wolf/Wolf Tracker 4.0/BackDoor.SLDPRT
381.0 x 215.9 x 4.76 mm
