DasunH/WolfTracker2014/Wolf/WolfTurret2.0/TurretShieldBacking.SLDPRT

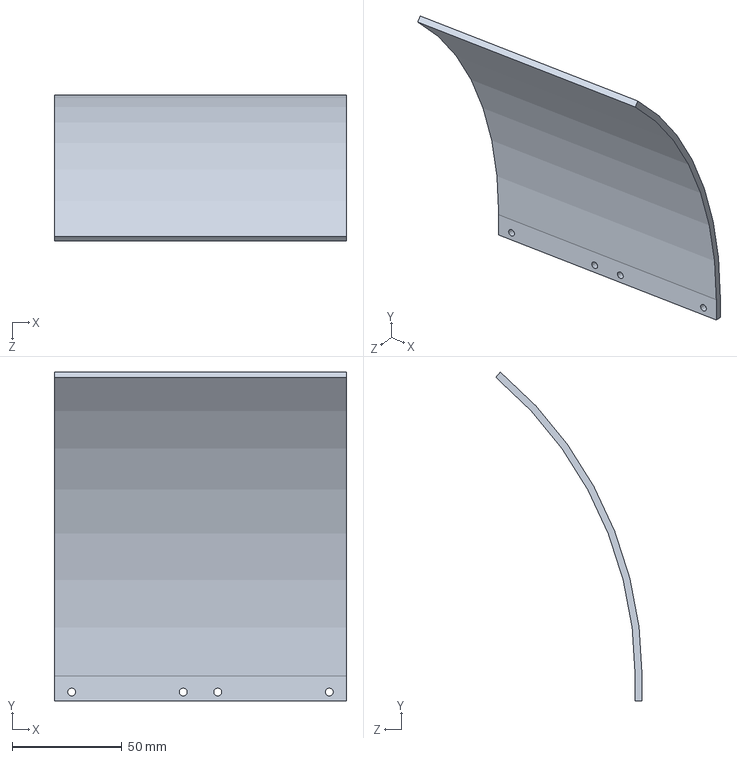
[picture p71: CAD file, 2014-09-02]
Wolf/WolfTurret2.0/TurretShieldBacking.SLDPRT
133.4 x 150.1 x 66.8 mm
