DasunH/WolfTracker2014/WolfTurret2.0/Swivel HubNut.SLDPRT

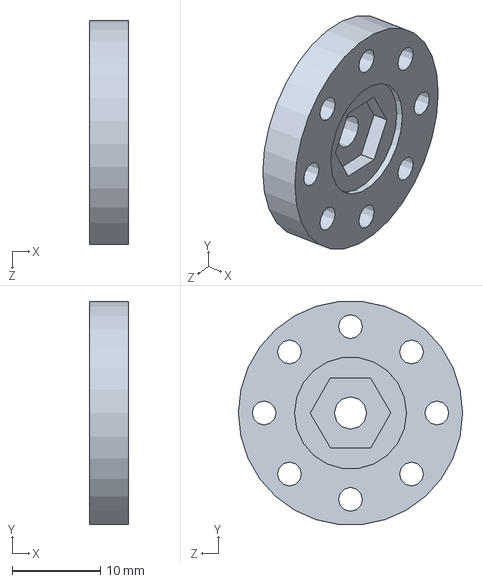
[picture p72: CAD file, 2014-09-02]
WolfTurret2.0/Swivel HubNut.SLDPRT
4.45 x 25.3 x 25.4 mm
