DasunH/WolfTracker2014/Wolf Tracker 2.0/Axel.SLDPRT

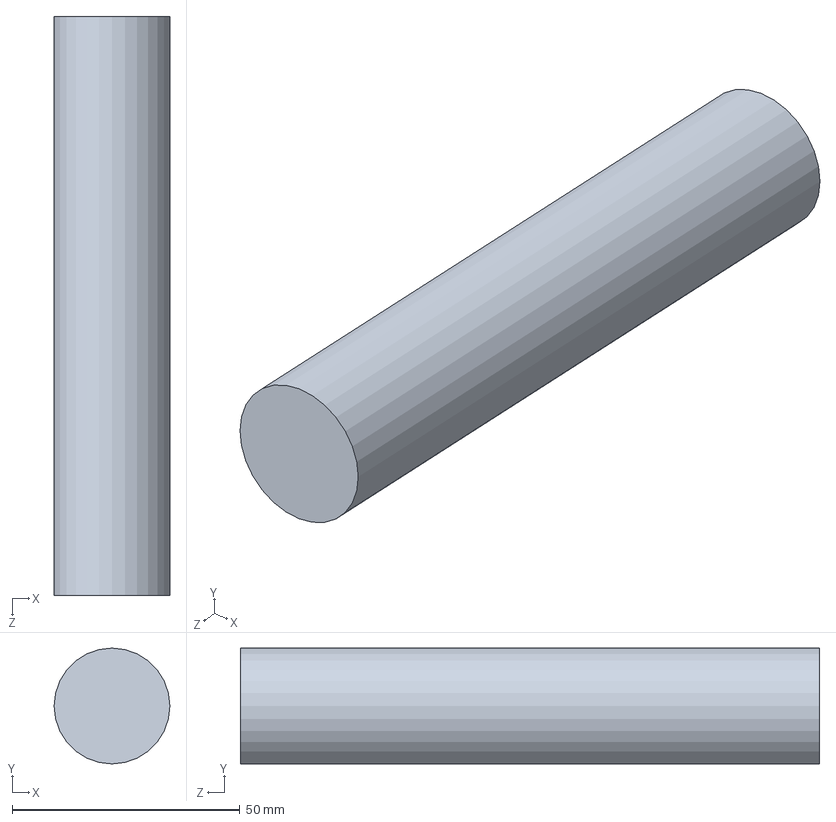
[picture p73: CAD file, 2014-09-02]
Wolf Tracker 2.0/Axel.SLDPRT
25.4 x 25.4 x 127.0 mm
