DasunH/WolfTracker2014/Wolf Tracker 4.0/BatteryRail2.SLDPRT

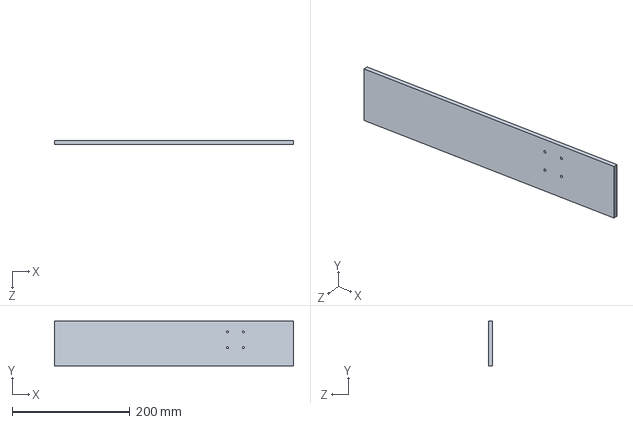
[picture p74: CAD file, 2014-09-02]
Wolf Tracker 4.0/BatteryRail2.SLDPRT
406.4 x 76.2 x 6.35 mm
