DasunH/WolfTracker2014/Wolf Tracker/Final V4/Final No9 Corner Bracket.SLDPRT

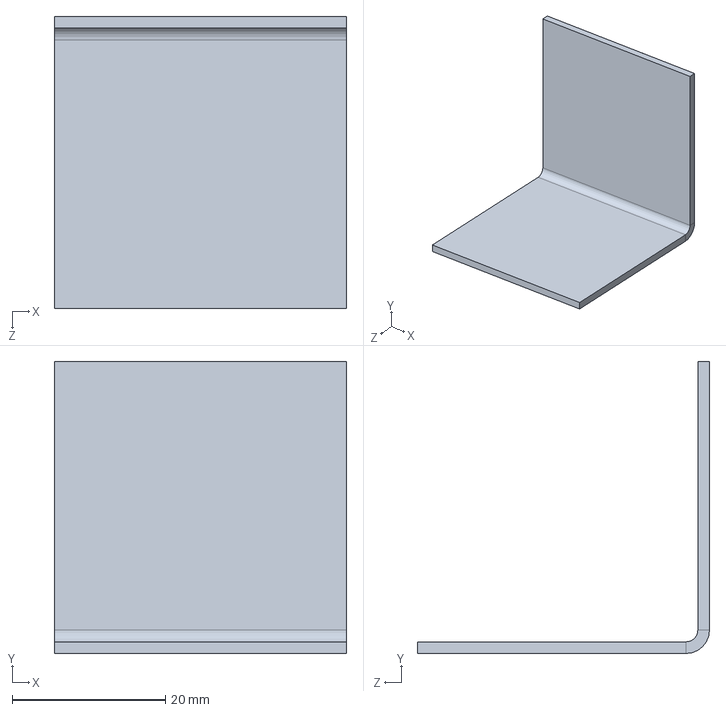
[picture p75: CAD file, 2014-09-02]
Wolf Tracker/Final V4/Final No9 Corner Bracket.SLDPRT
38.1 x 38.1 x 38.1 mm
