DasunH/WolfTracker2014/Wolf/Wolf Tracker 4.0/Final V4/Final Inside Corner Bracket.SLDPRT

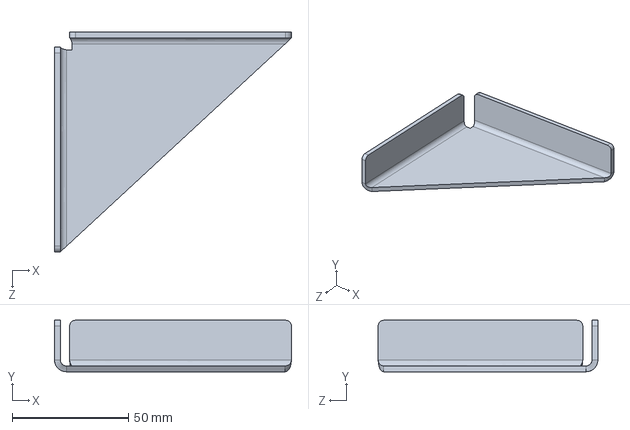
[picture p76: CAD file, 2014-09-02]
Wolf/Wolf Tracker 4.0/Final V4/Final Inside Corner Bracket.SLDPRT
102.1 x 22.2 x 94.7 mm
