DasunH/WolfTracker2014/Wolf/Wolf Tracker 4.0/WheelAdapter.SLDPRT

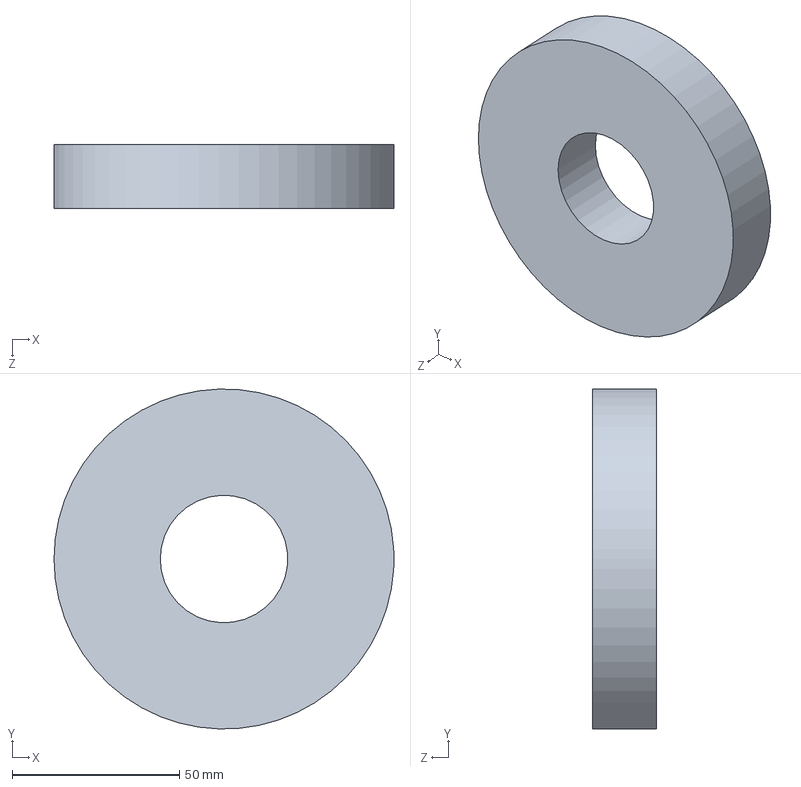
[picture p77: CAD file, 2014-09-02]
Wolf/Wolf Tracker 4.0/WheelAdapter.SLDPRT
101.6 x 101.6 x 19.1 mm
