DasunH/WolfTracker2014/Wolf/WolfTurret2.0/BottomMountingPlateTop2.SLDPRT

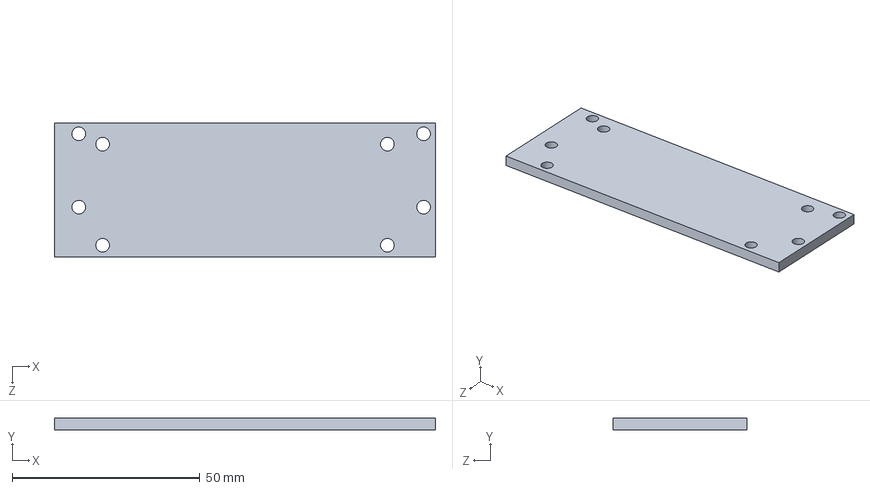
[picture p78: CAD file, 2014-09-02]
Wolf/WolfTurret2.0/BottomMountingPlateTop2.SLDPRT
101.6 x 3.17 x 35.8 mm
