DasunH/WolfTracker2014/WolfTurret2.0/SquareMountingBracket.SLDPRT

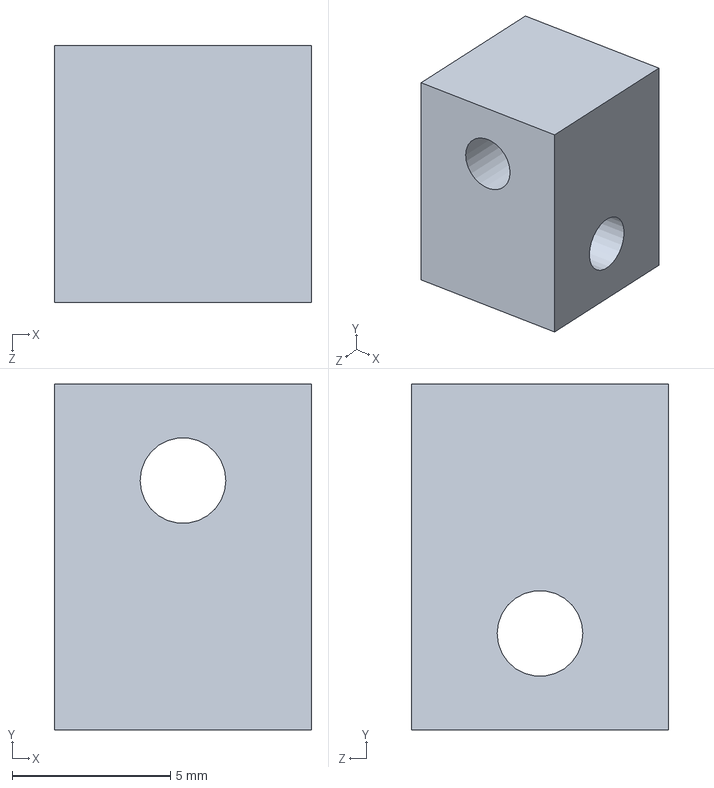
[picture p79: CAD file, 2014-09-02]
WolfTurret2.0/SquareMountingBracket.SLDPRT
8.13 x 10.9 x 8.13 mm
