DasunH/WolfTracker2014/Wolf Tracker 2.0/SproketPlate.SLDPRT

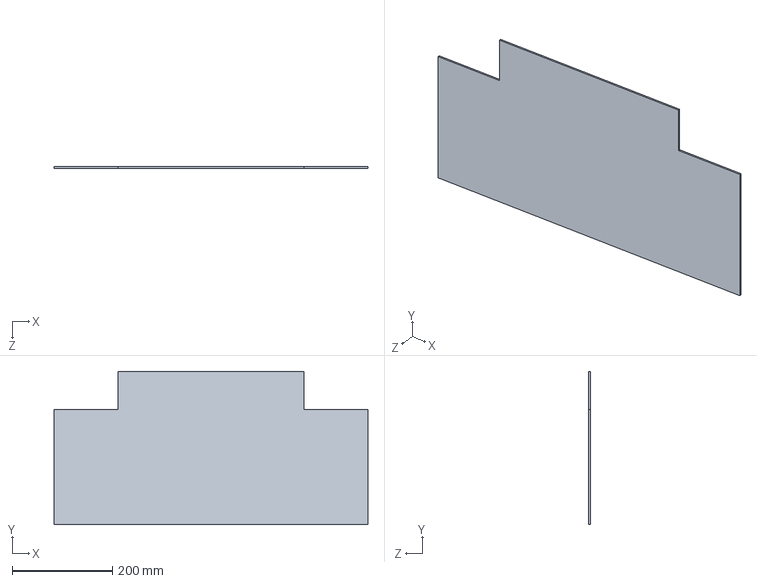
[picture p80: CAD file, 2014-09-02]
Wolf Tracker 2.0/SproketPlate.SLDPRT
625.5 x 304.8 x 3.17 mm
