DasunH/WolfTracker2014/Wolf Tracker 4.0/Final V4/Final Base-Bottom V4.SLDPRT

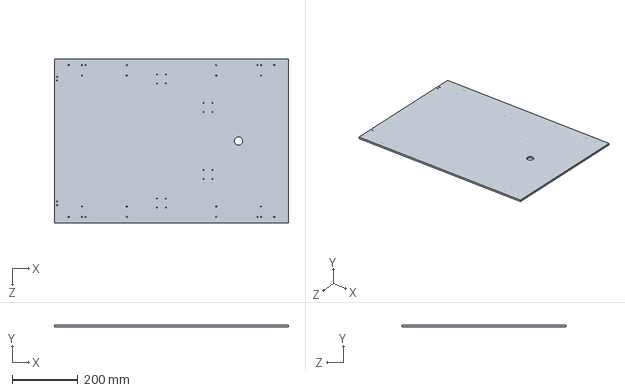
[picture p81: CAD file, 2014-09-02]
Wolf Tracker 4.0/Final V4/Final Base-Bottom V4.SLDPRT
714.4 x 6.35 x 501.6 mm
