DasunH/WolfTracker2014/Wolf Tracker 4.0/UnderrideGuardII.SLDPRT

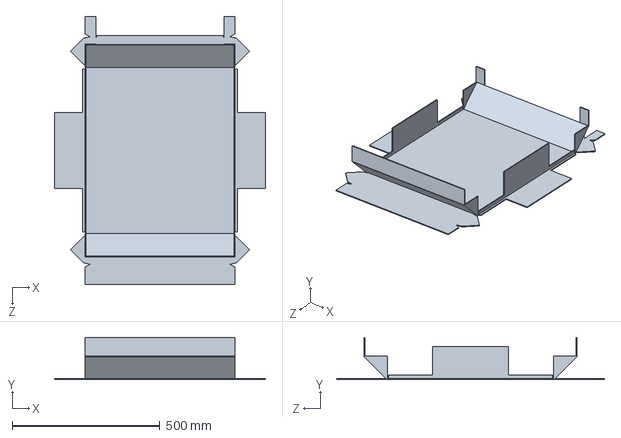
[picture p82: CAD file, 2014-09-02]
Wolf Tracker 4.0/UnderrideGuardII.SLDPRT
714.0 x 142.6 x 907.4 mm
