DasunH/WolfTracker2014/Wolf Tracker/Final V4/EZtop Dome.SLDPRT

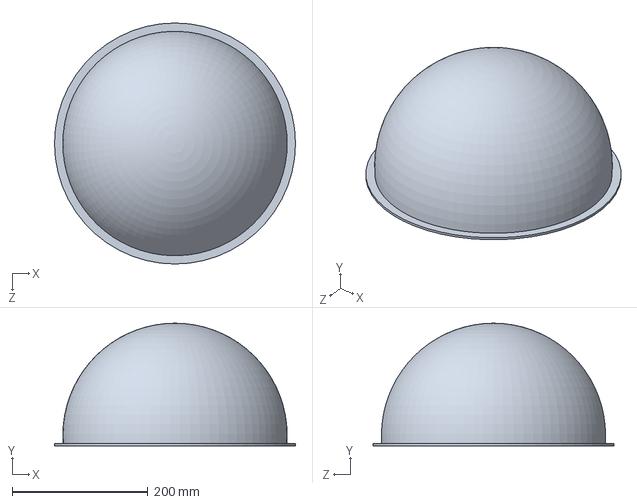
[picture p83: CAD file, 2014-09-02]
Wolf Tracker/Final V4/EZtop Dome.SLDPRT
355.6 x 181.0 x 355.6 mm
