DasunH/WolfTracker2014/Wolf/Wolf Tracker 4.0/Final V4/Final-CivicSolar Battery.SLDPRT

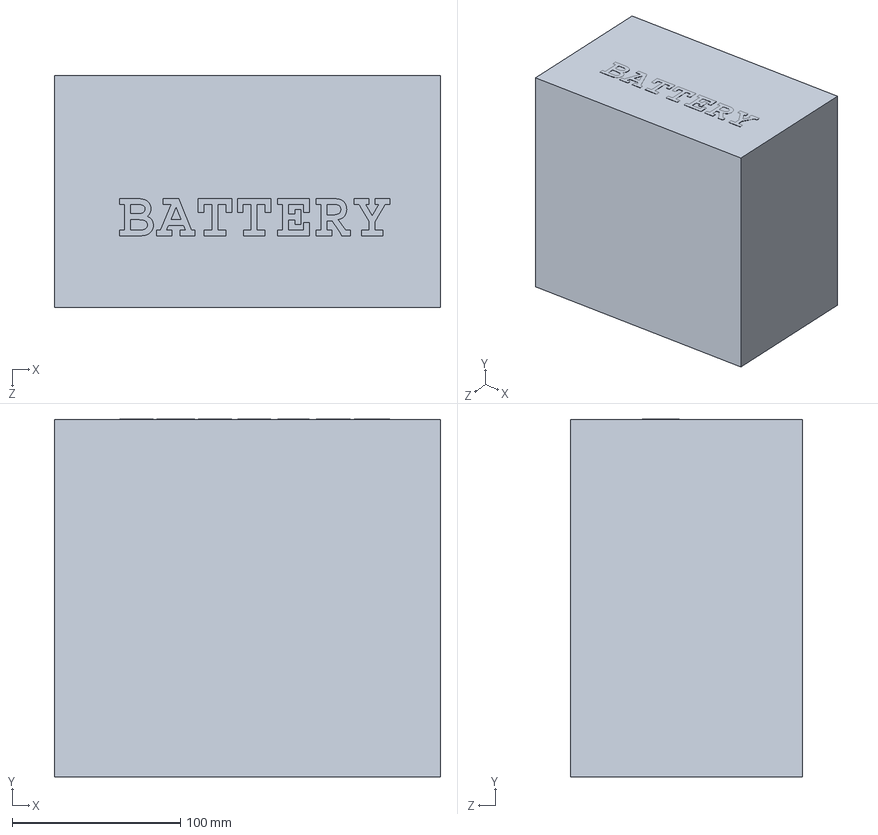
[picture p84: CAD file, 2014-09-02]
Wolf/Wolf Tracker 4.0/Final V4/Final-CivicSolar Battery.SLDPRT
229.1 x 212.3 x 137.9 mm
