DasunH/WolfTracker2014/Wolf Tracker 2.0/WheelCovers.SLDPRT

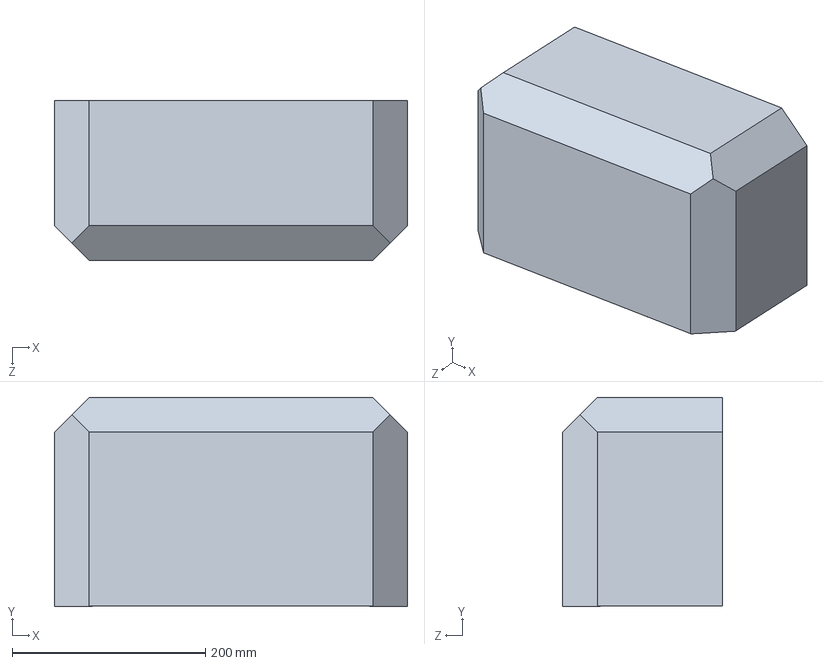
[picture p85: CAD file, 2014-09-02]
Wolf Tracker 2.0/WheelCovers.SLDPRT
365.1 x 216.3 x 165.1 mm
