DasunH/WolfTracker2014/WolfTurret2.0/QuarterServo.SLDPRT

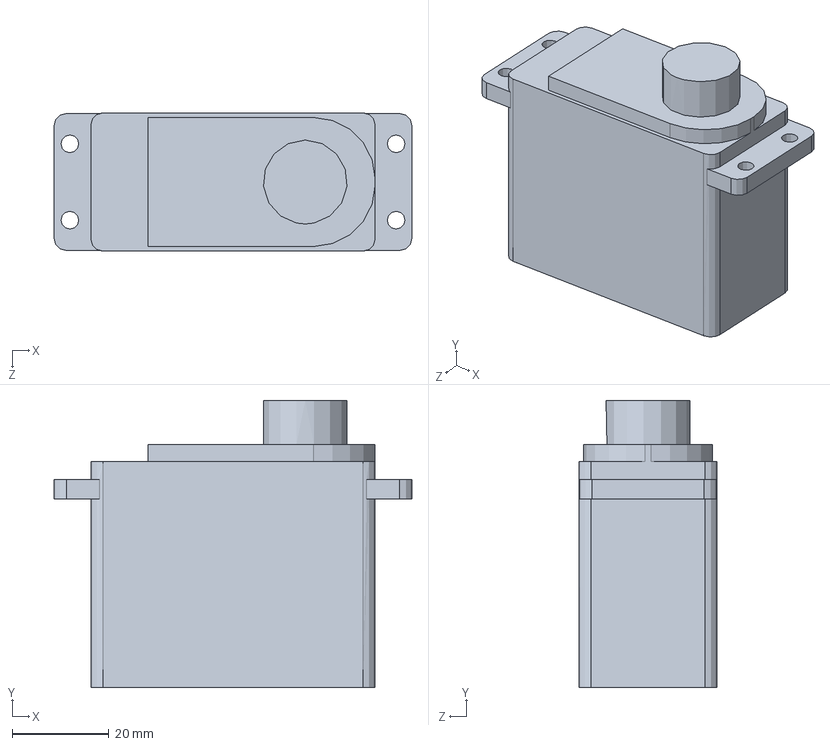
[picture p86: CAD file, 2014-09-02]
WolfTurret2.0/QuarterServo.SLDPRT
73.9 x 59.2 x 28.5 mm
