DasunH/WolfTracker2014/Wolf Tracker 2.0/Cover.SLDPRT

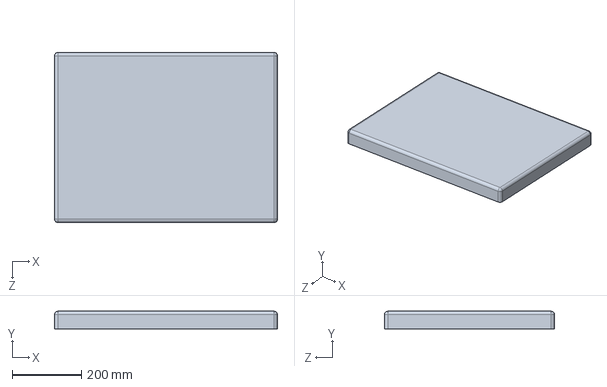
[picture p87: CAD file, 2014-09-02]
Wolf Tracker 2.0/Cover.SLDPRT
644.5 x 50.8 x 492.1 mm
