DasunH/WolfTracker2014/Wolf Tracker 4.0/Final V4/Final Base-LR V4.SLDPRT

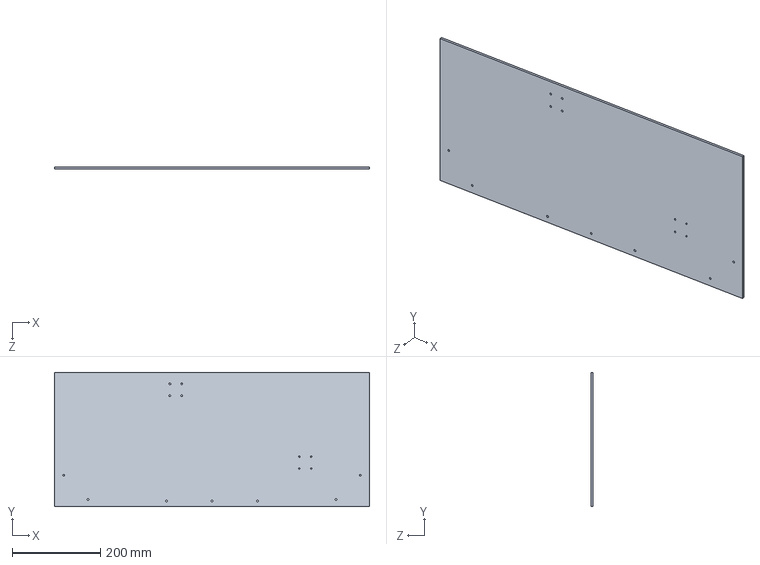
[picture p88: CAD file, 2014-09-02]
Wolf Tracker 4.0/Final V4/Final Base-LR V4.SLDPRT
714.4 x 304.8 x 4.76 mm
