DasunH/WolfTracker2014/Wolf Tracker/Final V4/Prototype ATR Tire V3.SLDPRT

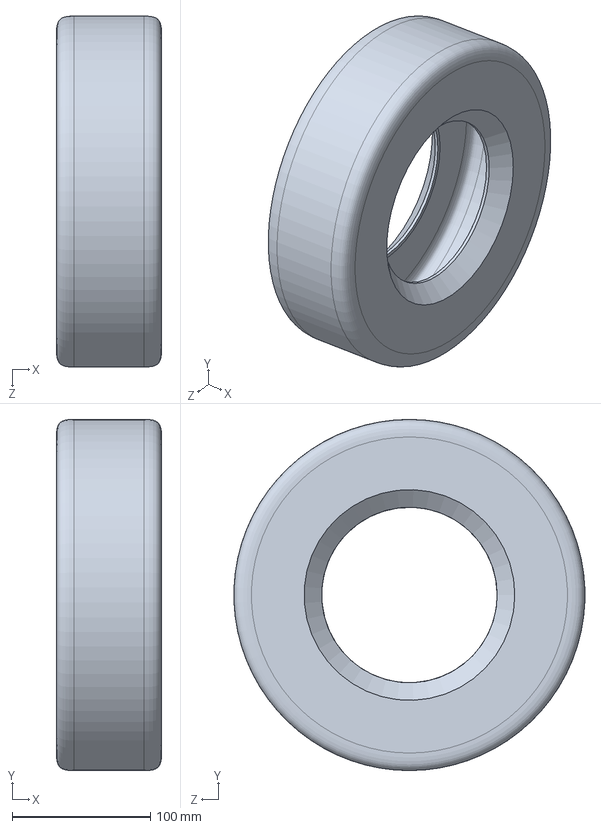
[picture p89: CAD file, 2014-09-02]
Wolf Tracker/Final V4/Prototype ATR Tire V3.SLDPRT
76.2 x 254.0 x 253.9 mm
