DasunH/WolfTracker2014/Wolf/Wolf Tracker 4.0/UnderrideGuardII.SLDPRT

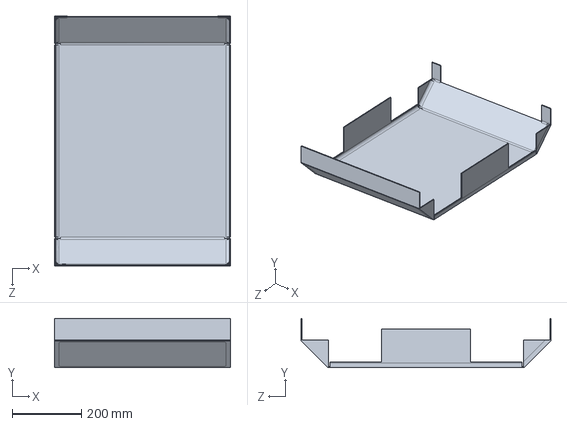
[picture p90: CAD file, 2014-09-02]
Wolf/Wolf Tracker 4.0/UnderrideGuardII.SLDPRT
508.0 x 142.6 x 720.9 mm
