DasunH/WolfTracker2014/WolfTurret2.0/OneBore76T.SLDPRT

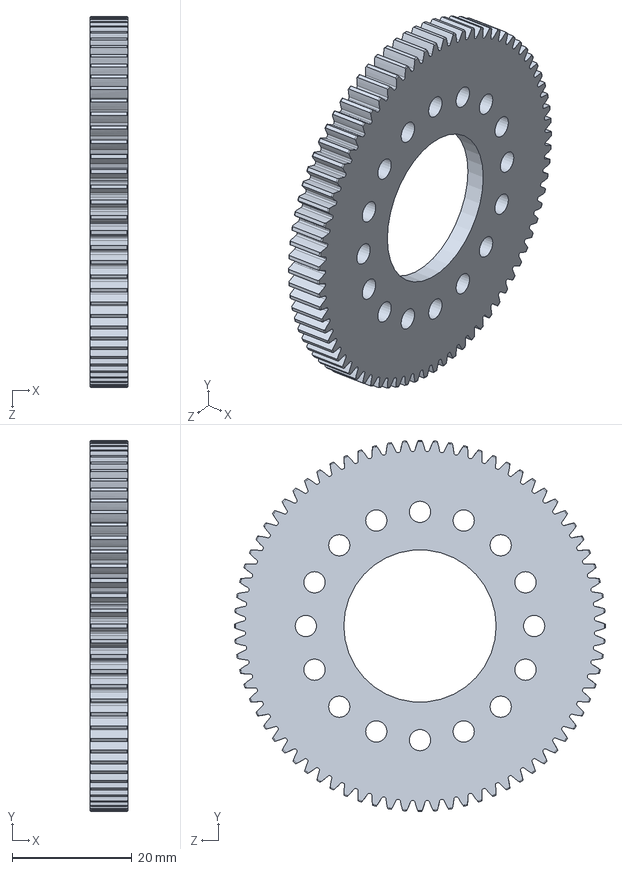
[picture p91: CAD file, 2014-09-02]
WolfTurret2.0/OneBore76T.SLDPRT
6.35 x 61.9 x 61.9 mm
