DasunH/WolfTracker2014/Wolf Tracker 2.0/SidePanel2.SLDPRT

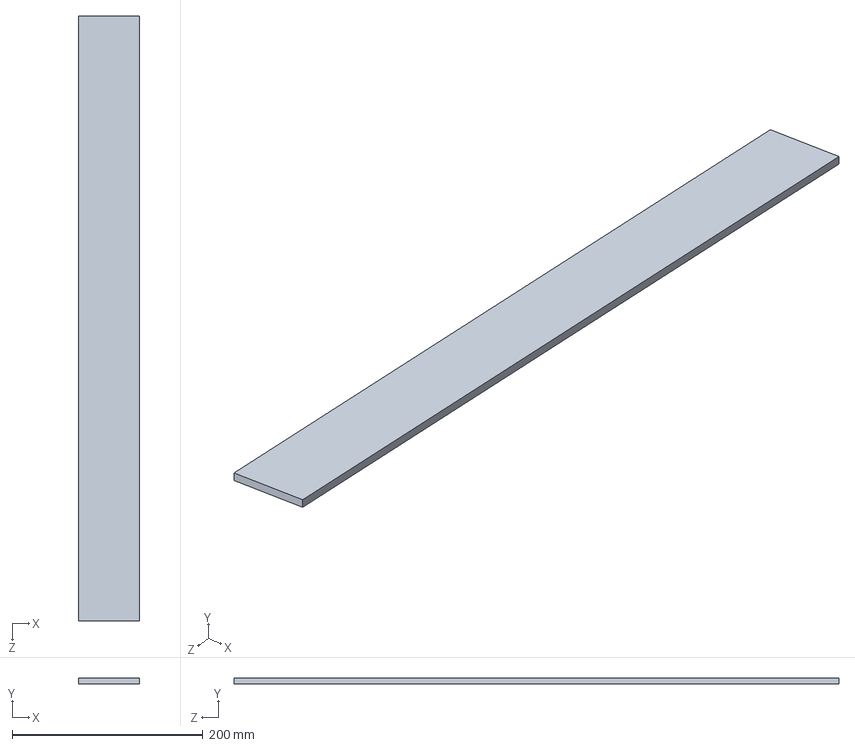
[picture p92: CAD file, 2014-09-02]
Wolf Tracker 2.0/SidePanel2.SLDPRT
63.5 x 6.35 x 635.0 mm
