DasunH/WolfTracker2014/Wolf Tracker 4.0/6-32-ButtonHead.SLDPRT

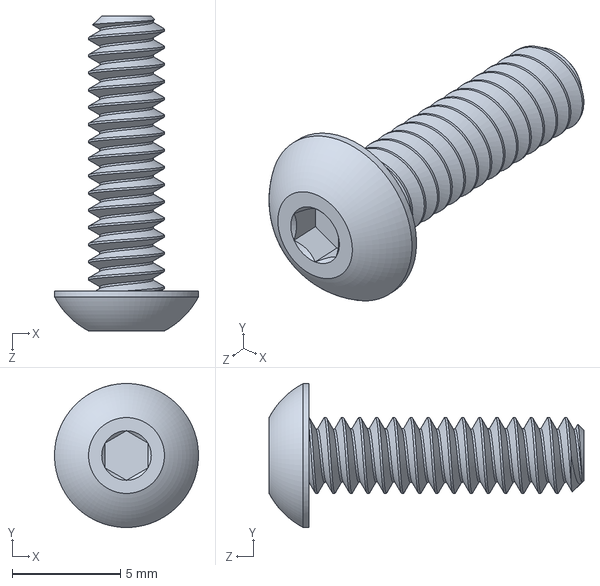
[picture p93: CAD file, 2014-09-02]
Wolf Tracker 4.0/6-32-ButtonHead.SLDPRT
6.65 x 6.65 x 14.6 mm
