DasunH/WolfTracker2014/Wolf/WolfTurret2.0/ServoMount2.SLDPRT

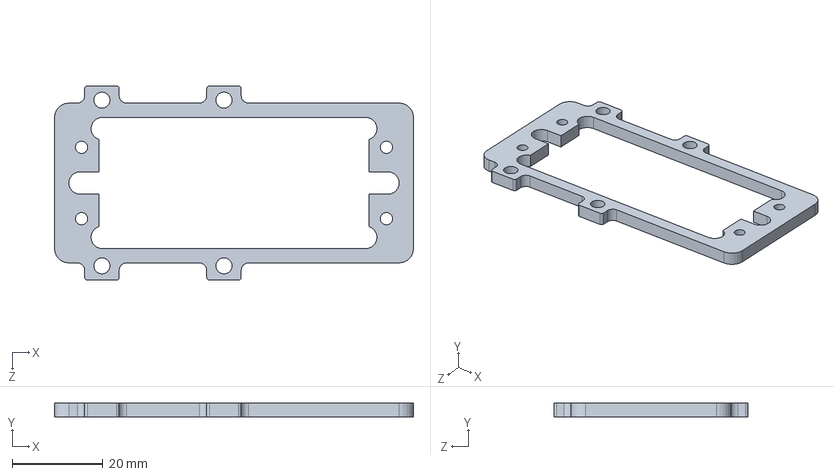
[picture p94: CAD file, 2014-09-02]
Wolf/WolfTurret2.0/ServoMount2.SLDPRT
79.2 x 3.17 x 42.9 mm
