DasunH/WolfTracker2014/WolfTurret2.0/HalfBore84TCUT.SLDPRT

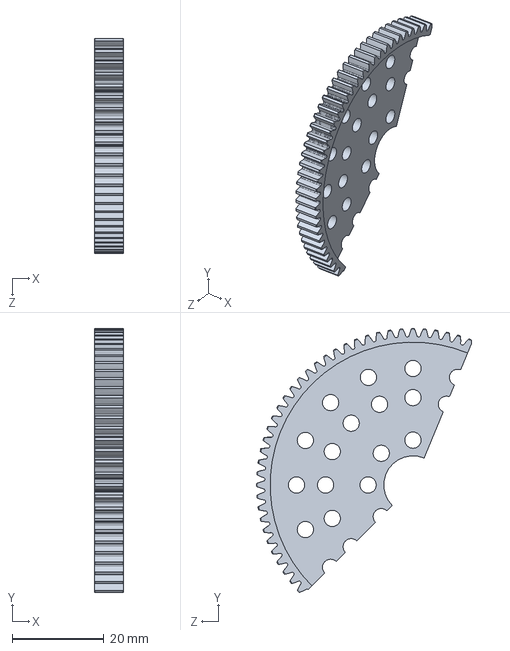
[picture p95: CAD file, 2014-09-02]
WolfTurret2.0/HalfBore84TCUT.SLDPRT
6.35 x 57.6 x 46.9 mm
