DasunH/WolfTracker2014/Wolf Tracker 2.0/PelicanCase.SLDPRT

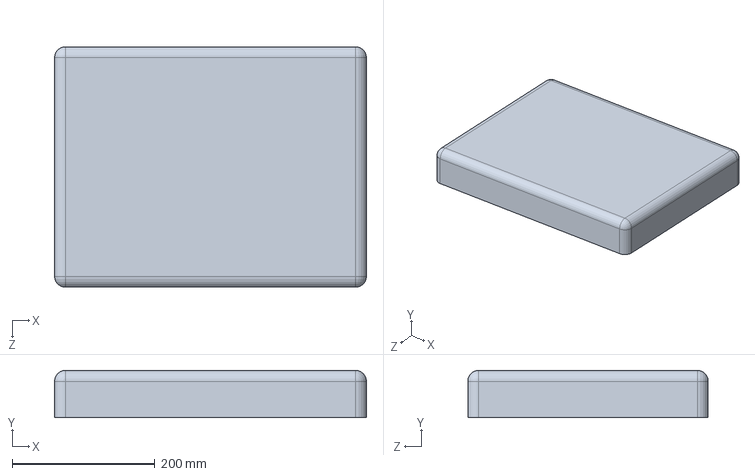
[picture p96: CAD file, 2014-09-02]
Wolf Tracker 2.0/PelicanCase.SLDPRT
436.4 x 66.0 x 336.3 mm
