DasunH/WolfTracker2014/Wolf/Wolf Tracker 4.0/Final V4/Prototype Gimbal Dome.SLDPRT

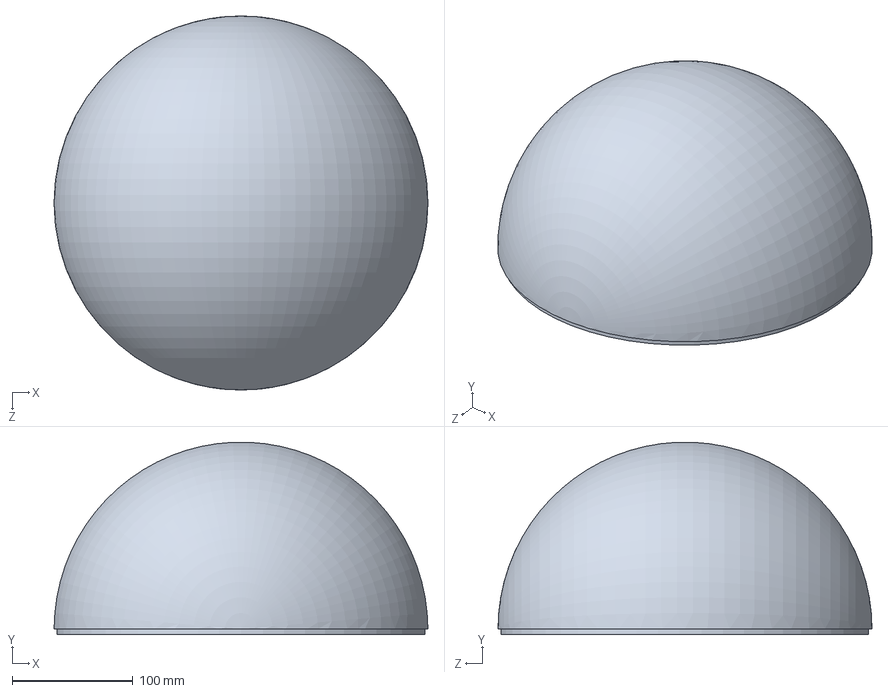
[picture p97: CAD file, 2014-09-02]
Wolf/Wolf Tracker 4.0/Final V4/Prototype Gimbal Dome.SLDPRT
309.9 x 159.4 x 309.9 mm
