DasunH/WolfTracker2014/Wolf/WolfTurret2.0/.5InchBore76ToothGear.SLDPRT

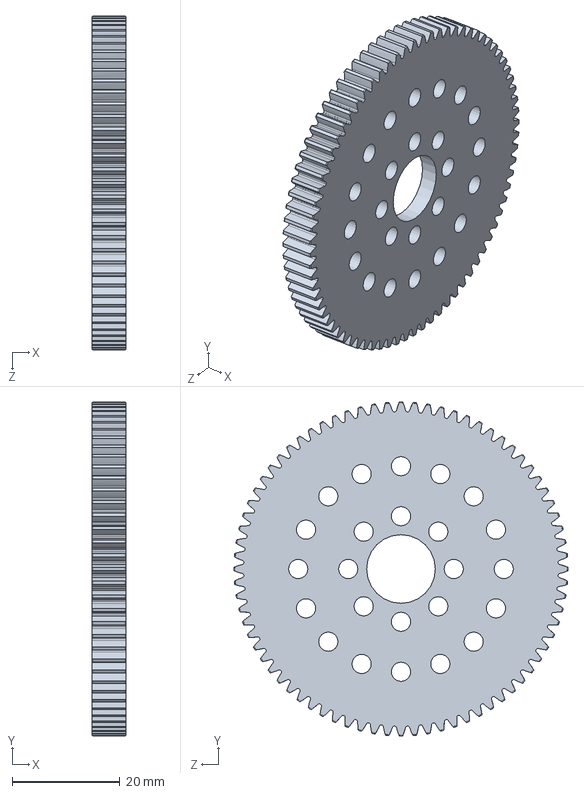
[picture p98: CAD file, 2014-09-02]
Wolf/WolfTurret2.0/.5InchBore76ToothGear.SLDPRT
6.35 x 61.9 x 61.9 mm
