DasunH/WolfTracker2014/Wolf Tracker 2.0/Front-Back.SLDPRT

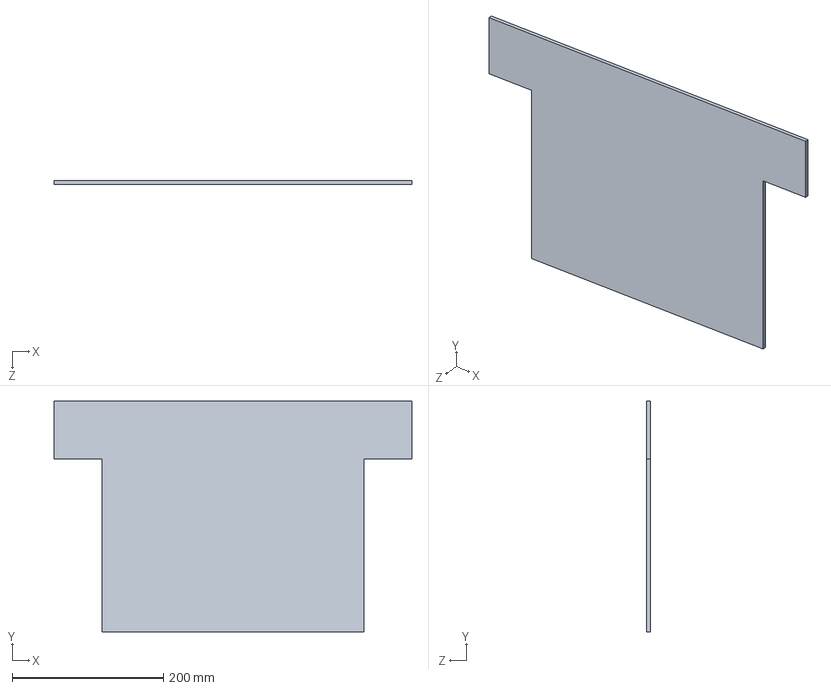
[picture p99: CAD file, 2014-09-02]
Wolf Tracker 2.0/Front-Back.SLDPRT
473.1 x 304.8 x 4.76 mm
