DasunH/WolfTracker2014/Wolf Tracker/Final V4/Final Base-LR V4.SLDPRT

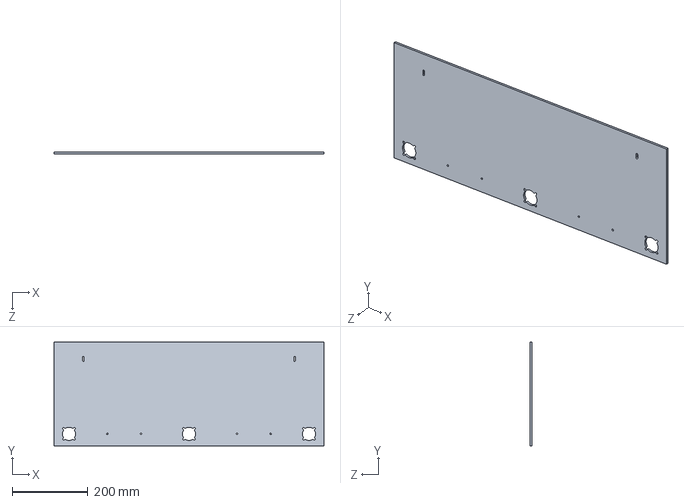
[picture p100: CAD file, 2014-09-02]
Wolf Tracker/Final V4/Final Base-LR V4.SLDPRT
714.4 x 274.6 x 4.76 mm
