DasunH/WolfTracker2014/Wolf/WolfTurret2.0/Turntable.SLDPRT

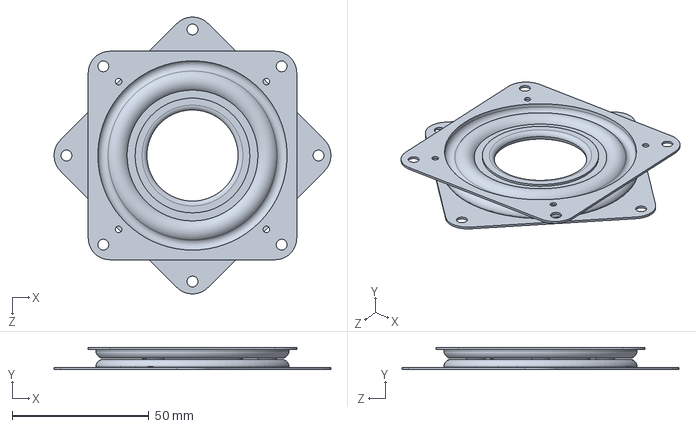
[picture p101: CAD file, 2014-09-02]
Wolf/WolfTurret2.0/Turntable.SLDPRT
101.2 x 8.13 x 101.2 mm
