DasunH/WolfTracker2014/Wolf Tracker 2.0/Wheel.SLDPRT

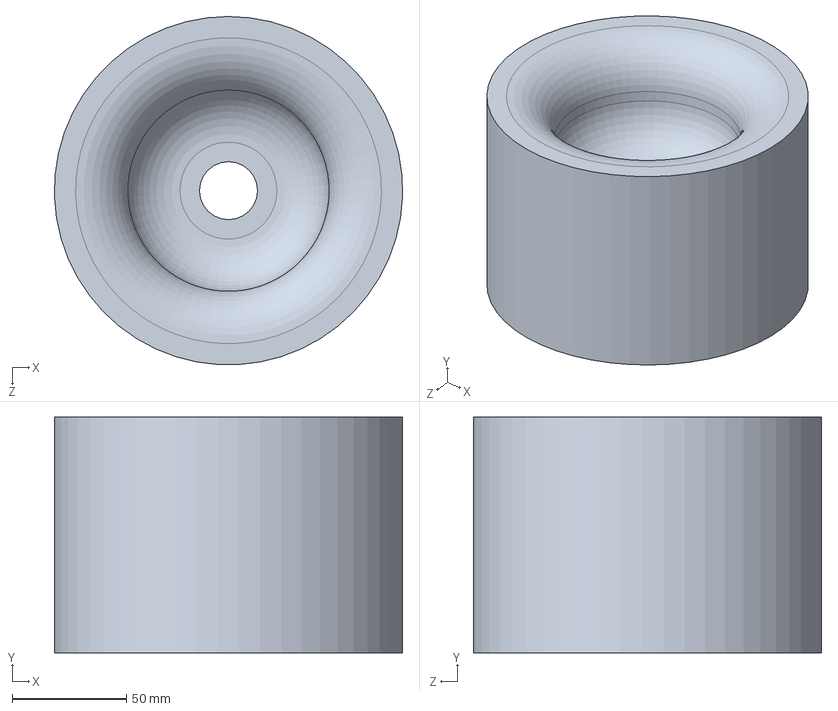
[picture p102: CAD file, 2014-09-02]
Wolf Tracker 2.0/Wheel.SLDPRT
152.3 x 103.1 x 152.3 mm
