DasunH/WolfTracker2014/WolfTurret2.0/CameraMountingDimensions3.STL

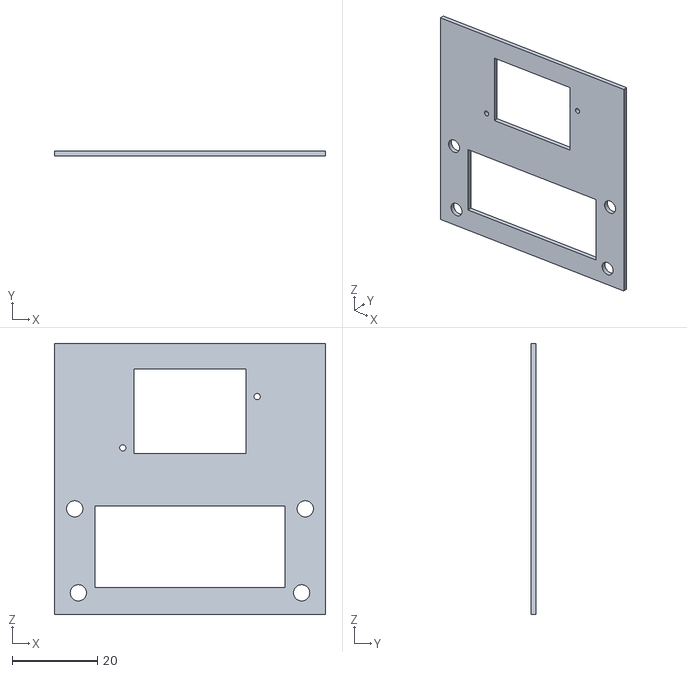
[picture p103: CAD file, 2014-09-02]
WolfTurret2.0/CameraMountingDimensions3.STL
63.5 x 1.27 x 63.5
