DasunH/WolfTracker2014/Wolf Tracker 2.0/Base.SLDPRT

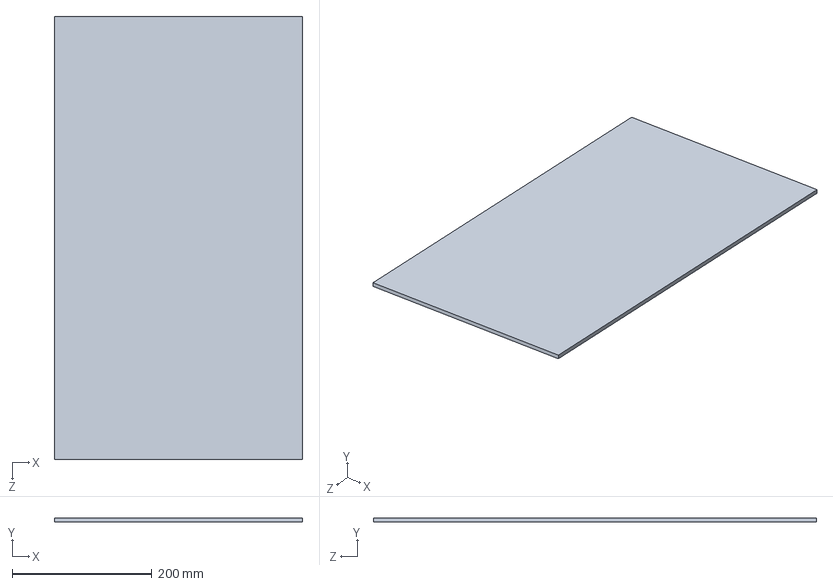
[picture p104: CAD file, 2014-09-02]
Wolf Tracker 2.0/Base.SLDPRT
355.6 x 6.35 x 635.0 mm
