DasunH/WolfTracker2014/Wolf/WolfTurret2.0/TurretShell.SLDPRT

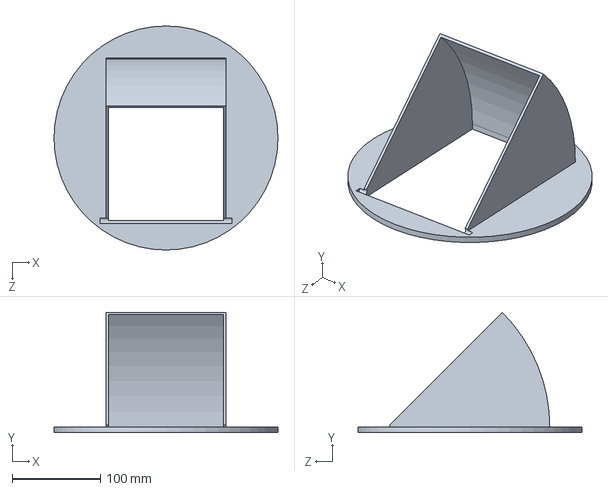
[picture p106: CAD file, 2014-09-02]
Wolf/WolfTurret2.0/TurretShell.SLDPRT
254.0 x 136.6 x 254.0 mm
