DasunH/WolfTracker2014/WolfTurret2.0/AngleBracket.SLDPRT

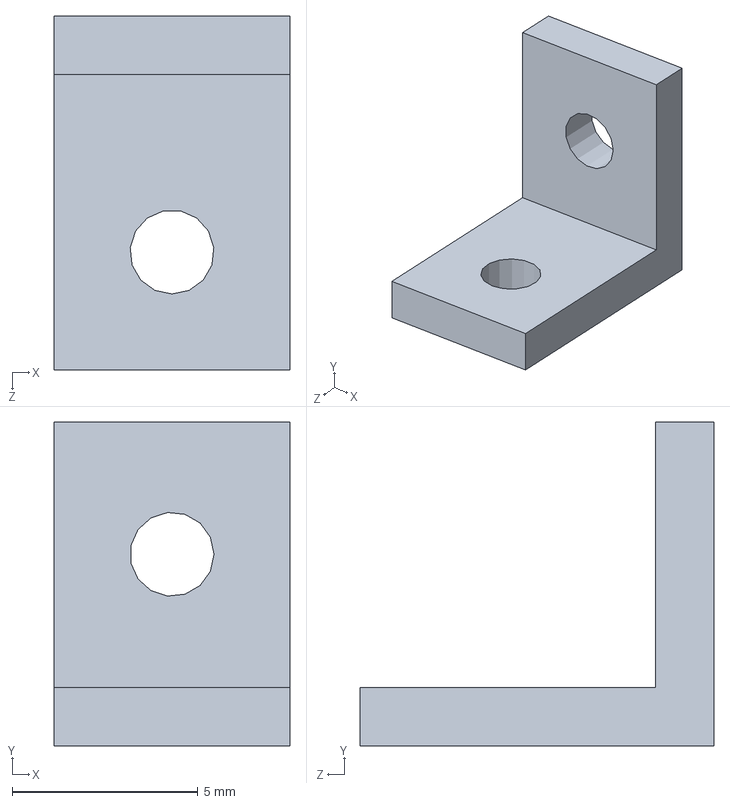
[picture p107: CAD file, 2014-09-02]
WolfTurret2.0/AngleBracket.SLDPRT
6.35 x 8.71 x 9.53 mm
