DasunH/WolfTracker2014/Wolf Tracker 2.0/SidePanel3.SLDPRT

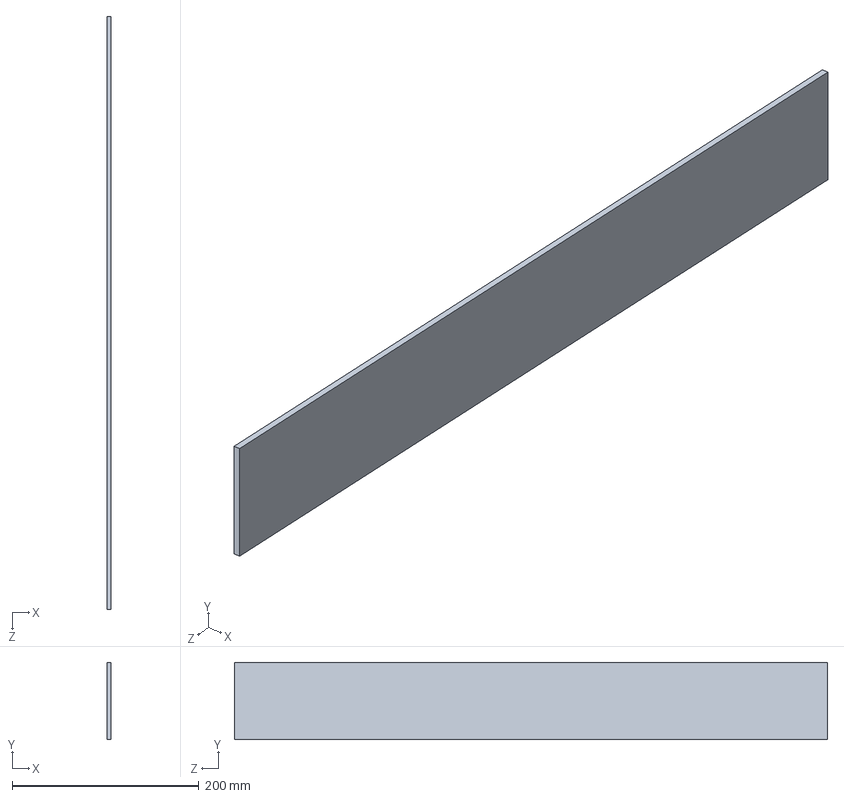
[picture p108: CAD file, 2014-09-02]
Wolf Tracker 2.0/SidePanel3.SLDPRT
4.76 x 82.5 x 635.0 mm
