DasunH/WolfTracker2014/Wolf/Wolf Tracker 4.0/CornerBracket.SLDPRT

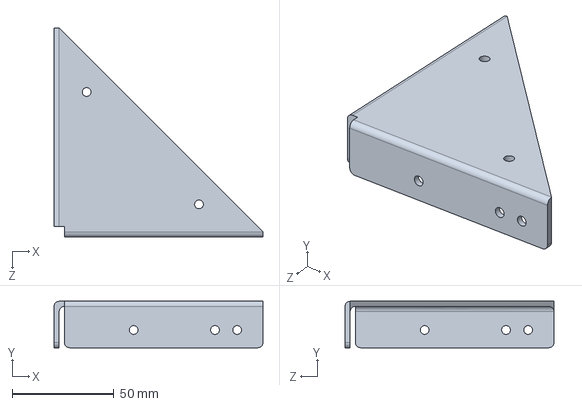
[picture p109: CAD file, 2014-09-02]
Wolf/Wolf Tracker 4.0/CornerBracket.SLDPRT
102.6 x 22.9 x 102.6 mm
