DasunH/WolfTracker2014/Wolf/Wolf Tracker 4.0/Final V4/Final Tire Cover V4B.SLDPRT

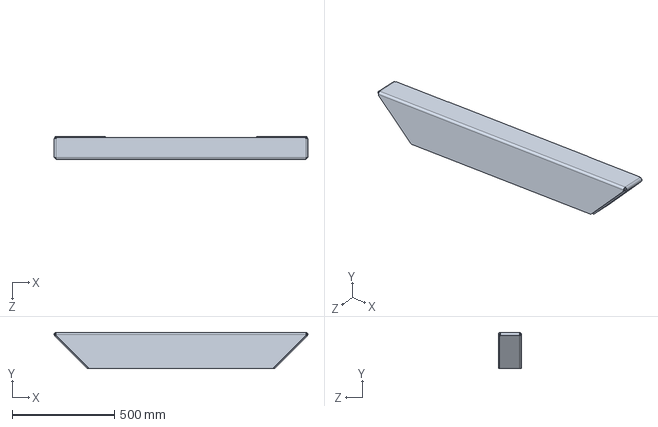
[picture p110: CAD file, 2014-09-02]
Wolf/Wolf Tracker 4.0/Final V4/Final Tire Cover V4B.SLDPRT
1243.1 x 177.8 x 114.3 mm
