DasunH/WolfTracker2014/WolfTurret2.0/2by4.SLDPRT

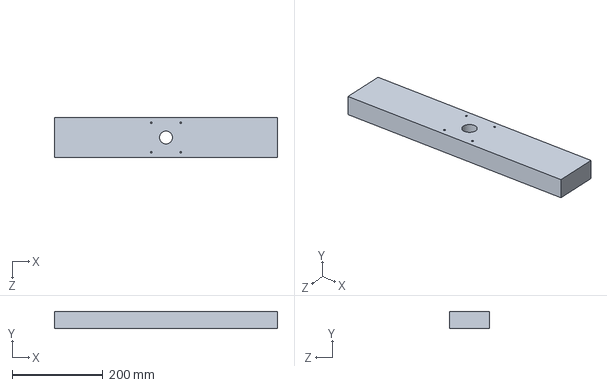
[picture p111: CAD file, 2014-09-02]
WolfTurret2.0/2by4.SLDPRT
492.3 x 38.1 x 88.9 mm
