DasunH/WolfTracker2014/Wolf/WolfTurret2.0/TurretSideProtection.SLDPRT

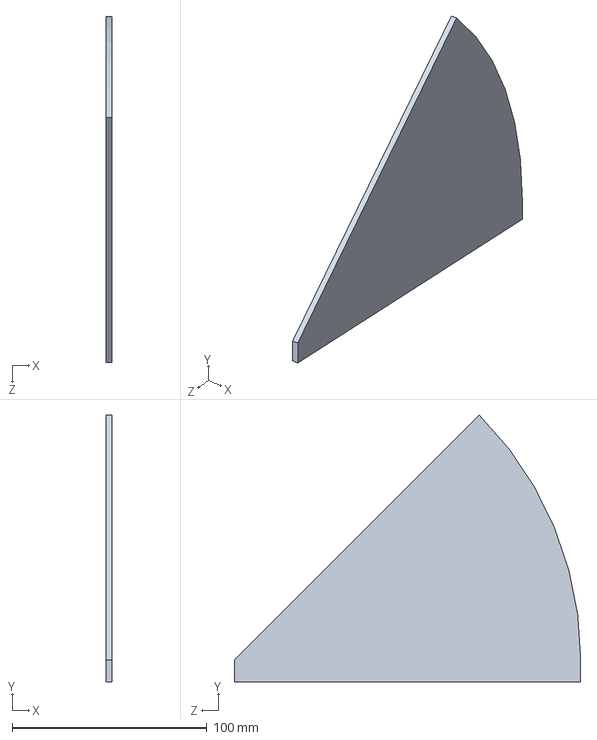
[picture p112: CAD file, 2014-09-02]
Wolf/WolfTurret2.0/TurretSideProtection.SLDPRT
3.17 x 137.2 x 178.1 mm
