DasunH/WolfTracker2014/(list of files, cad)

Other CAD files:
Wolf/Wolf Tracker 4.0/Final V4/Final ATR Drivetrain Assembly V4.SLDASM
Wolf/Wolf Tracker 4.0/Final V4/Final Shelf Assembly V4.SLDASM
Wolf Tracker 4.0/Final V4/Final Shelf Assembly V4.SLDASM
Wolf Tracker 4.0/Final V4/Final ATR Drivetrain Assembly V4.SLDASM
Wolf Tracker 4.0/PelicanLBracket.STEP
Wolf Tracker 4.0/Final V4/Final Aluminum Bar V4.SLDPRT
Wolf Tracker/Final V4/Final Base-Bottom V4.SLDPRT
Wolf/Wolf Tracker 4.0/BatteryRail2.SLDPRT
Wolf/Wolf Tracker 4.0/Block.STEP
Wolf Tracker 4.0/Block.STEP
Wolf Tracker 4.0/CornerBracket.SLDPRT
Wolf/Wolf Tracker 4.0/PelicanLBracket.STEP
WolfTurret2.0/ServoMount.SLDPRT
Wolf Tracker 4.0/585494.STEP
Wolf Tracker 4.0/BackDoor.SLDDRW
Wolf Tracker 4.0/BackPlateAssembly.SLDDRW
Wolf Tracker 4.0/Block.SLDPRT
Wolf Tracker 4.0/DoorBottomBracket.SLDPRT
Wolf Tracker 4.0/Final V4/6-32 0.5'' Stainless Steel Screw.SLDPRT
Wolf Tracker 4.0/Final V4/6-32 Stainless Steel Hex Nut.SLDPRT
Wolf Tracker 4.0/Final V4/6-32 Washer.SLDPRT
Wolf Tracker 4.0/Final V4/8-32 0.5'' Stainless Steel Screw.SLDPRT
Wolf Tracker 4.0/Final V4/8-32 3.0'' Stainless Steel Screw.SLDPRT
Wolf Tracker 4.0/Final V4/8-32 Stainless Steel Hex Nut.SLDPRT
Wolf Tracker 4.0/Final V4/8-32 Washer.SLDPRT
Wolf Tracker 4.0/Final V4/Atom Board.SLDPRT
Wolf Tracker 4.0/Final V4/Final 24-12V Converter.SLDPRT
Wolf Tracker 4.0/Final V4/Final Aluminum Bar V4II.SLDDRW
Wolf Tracker 4.0/Final V4/Final Base-Bottom V4.SLDDRW
Wolf Tracker 4.0/Final V4/Final Base-FB V4.SLDDRW
Wolf Tracker 4.0/Final V4/Final Base-FB V4.SLDPRT
Wolf Tracker 4.0/Final V4/Final Base-LR V4.SLDDRW
Wolf Tracker 4.0/Final V4/Final Case Top V4.SLDPRT
Wolf Tracker 4.0/Final V4/Final F Latch.SLDPRT
Wolf Tracker 4.0/Final V4/Final T Bar.SLDPRT
Wolf Tracker 4.0/Final V4/PVC Pipe.SLDPRT
Wolf Tracker 4.0/Final V4/Prototype ATR Wheel Hub V3.SLDPRT
Wolf Tracker 4.0/Final V4/Router Table/Final Base-Bottom V4.x_t
Wolf Tracker 4.0/Final V4/Router Table/Final Base-FB V4.x_t
Wolf Tracker 4.0/Final V4/Router Table/Final Base-LR V4.x_t
Wolf Tracker 4.0/Final V4/Router Table/Final Case Top V4.x_t
Wolf Tracker 4.0/Final V4/Router Table/Final Tire Cover V4B.x_t
Wolf Tracker 4.0/New Back Plate.SLDDRW
Wolf Tracker 4.0/UnderrideGuardII.SLDDRW
Wolf Tracker/Final V4/6-32 0.5'' Stainless Steel Screw.SLDPRT
Wolf Tracker/Final V4/6-32 Stainless Steel Hex Nut.SLDPRT
Wolf Tracker/Final V4/6-32 Washer.SLDPRT
Wolf Tracker/Final V4/8-32 0.5'' Stainless Steel Screw.SLDPRT
Wolf Tracker/Final V4/8-32 3.0'' Stainless Steel Screw.SLDPRT
Wolf Tracker/Final V4/8-32 Stainless Steel Hex Nut.SLDPRT
Wolf Tracker/Final V4/8-32 Washer.SLDPRT
Wolf Tracker/Final V4/Atom Board.SLDPRT
Wolf Tracker/Final V4/Final 24-12V Converter.SLDPRT
Wolf Tracker/Final V4/Final Case Top V4.SLDPRT
Wolf Tracker/Final V4/Final F Latch.SLDPRT
Wolf Tracker/Final V4/Final T Bar.SLDPRT
Wolf Tracker/Final V4/PVC Pipe.SLDPRT
Wolf Tracker/Final V4/Prototype ATR Wheel Hub V3.SLDPRT
Wolf Tracker/Final V4/Router Table/Final Base-Bottom V4.x_t
Wolf Tracker/Final V4/Router Table/Final Base-FB V4.x_t
Wolf Tracker/Final V4/Router Table/Final Base-LR V4.x_t
Wolf Tracker/Final V4/Router Table/Final Case Top V4.x_t
Wolf Tracker/Final V4/Router Table/Final Tire Cover V4B.x_t
Wolf/Wolf Tracker 4.0/585494.STEP
Wolf/Wolf Tracker 4.0/BackDoor.SLDDRW
Wolf/Wolf Tracker 4.0/BackPlateAssembly.SLDDRW
Wolf/Wolf Tracker 4.0/Block.SLDPRT
Wolf/Wolf Tracker 4.0/DoorBottomBracket.SLDPRT
Wolf/Wolf Tracker 4.0/Final V4/6-32 0.5'' Stainless Steel Screw.SLDPRT
Wolf/Wolf Tracker 4.0/Final V4/6-32 Stainless Steel Hex Nut.SLDPRT
Wolf/Wolf Tracker 4.0/Final V4/6-32 Washer.SLDPRT
Wolf/Wolf Tracker 4.0/Final V4/8-32 0.5'' Stainless Steel Screw.SLDPRT
Wolf/Wolf Tracker 4.0/Final V4/8-32 3.0'' Stainless Steel Screw.SLDPRT
Wolf/Wolf Tracker 4.0/Final V4/8-32 Stainless Steel Hex Nut.SLDPRT
Wolf/Wolf Tracker 4.0/Final V4/8-32 Washer.SLDPRT
Wolf/Wolf Tracker 4.0/Final V4/Atom Board.SLDPRT
Wolf/Wolf Tracker 4.0/Final V4/Final 24-12V Converter.SLDPRT
Wolf/Wolf Tracker 4.0/Final V4/Final Aluminum Bar V4.SLDPRT
Wolf/Wolf Tracker 4.0/Final V4/Final Aluminum Bar V4II.SLDDRW
Wolf/Wolf Tracker 4.0/Final V4/Final Base-Bottom V4.SLDDRW
Wolf/Wolf Tracker 4.0/Final V4/Final Base-FB V4.SLDDRW
Wolf/Wolf Tracker 4.0/Final V4/Final Base-FB V4.SLDPRT
Wolf/Wolf Tracker 4.0/Final V4/Final Base-LR V4.SLDDRW
Wolf/Wolf Tracker 4.0/Final V4/Final Base-LR V4.SLDPRT
Wolf/Wolf Tracker 4.0/Final V4/Final F Latch.SLDPRT
Wolf/Wolf Tracker 4.0/Final V4/Final T Bar.SLDPRT
Wolf/Wolf Tracker 4.0/Final V4/PVC Pipe.SLDPRT
Wolf/Wolf Tracker 4.0/Final V4/Prototype ATR Wheel Hub V3.SLDPRT
Wolf/Wolf Tracker 4.0/Final V4/Router Table/Final Base-Bottom V4.x_t
Wolf/Wolf Tracker 4.0/Final V4/Router Table/Final Base-FB V4.x_t
Wolf/Wolf Tracker 4.0/Final V4/Router Table/Final Base-LR V4.x_t
Wolf/Wolf Tracker 4.0/Final V4/Router Table/Final Case Top V4.x_t
Wolf/Wolf Tracker 4.0/Final V4/Router Table/Final Tire Cover V4B.x_t
Wolf/Wolf Tracker 4.0/New Back Plate.SLDDRW
Wolf/WolfTurret2.0/AllignmentDowel.SLDPRT
Wolf/WolfTurret2.0/BottomMountingPlate.SLDPRT
Wolf/WolfTurret2.0/BottomMountingPlateTop.SLDPRT
Wolf/WolfTurret2.0/CameraMountingDimensions2.SLDPRT
Wolf/WolfTurret2.0/ChannelABracket.SLDPRT
Wolf/WolfTurret2.0/CircleMountingBracket.SLDPRT
Wolf/WolfTurret2.0/HalfBore84T.SLDPRT
Wolf/WolfTurret2.0/HexScrew(.1875).SLDPRT
Wolf/WolfTurret2.0/HexScrew(.25).SLDPRT
Wolf/WolfTurret2.0/HexScrew(.3125).SLDPRT
Wolf/WolfTurret2.0/HexStandoff.SLDPRT
Wolf/WolfTurret2.0/LongSquareBracket.SLDPRT
Wolf/WolfTurret2.0/OneInchStandoff.SLDPRT
Wolf/WolfTurret2.0/PVCShield.SLDPRT
Wolf/WolfTurret2.0/ServoMount.SLDPRT
Wolf/WolfTurret2.0/Spacer.SLDPRT
Wolf/WolfTurret2.0/SteelTube.SLDPRT
Wolf/WolfTurret2.0/Swivel HubScrew.SLDPRT
Wolf/WolfTurret2.0/TriangleMountingBracket.SLDPRT
Wolf/WolfTurret2.0/TubeMount.SLDPRT
Wolf/WolfTurret2.0/TurningPlate.SLDPRT
Wolf/WolfTurret2.0/Turret.SLDPRT
Wolf/WolfTurret2.0/TurretBackPlate.SLDPRT
Wolf/WolfTurret2.0/TurretBasePlate.SLDPRT
Wolf/WolfTurret2.0/TurretFrontPannel.SLDPRT
Wolf/WolfTurret2.0/TurretSideProtectionLeft.SLDPRT
Wolf/WolfTurret2.0/TurretSideProtectionRight.SLDPRT
WolfTurret2.0/AllignmentDowel.SLDPRT
WolfTurret2.0/BottomMountingPlate.SLDPRT
WolfTurret2.0/BottomMountingPlateTop.SLDPRT
WolfTurret2.0/CameraMountingDimensions2.SLDPRT
WolfTurret2.0/ChannelABracket.SLDPRT
WolfTurret2.0/CircleMountingBracket.SLDPRT
WolfTurret2.0/HalfBore84T.SLDPRT
WolfTurret2.0/HexScrew(.1875).SLDPRT
WolfTurret2.0/HexScrew(.25).SLDPRT
WolfTurret2.0/HexScrew(.3125).SLDPRT
WolfTurret2.0/HexStandoff.SLDPRT
WolfTurret2.0/LongSquareBracket.SLDPRT
WolfTurret2.0/OneInchStandoff.SLDPRT
WolfTurret2.0/PVCShield.SLDPRT
WolfTurret2.0/Spacer.SLDPRT
WolfTurret2.0/SteelTube.SLDPRT
WolfTurret2.0/Swivel HubScrew.SLDPRT
WolfTurret2.0/TriangleMountingBracket.SLDPRT
WolfTurret2.0/TubeMount.SLDPRT
